vasimv/OMower/hardware/omower.schematics.png

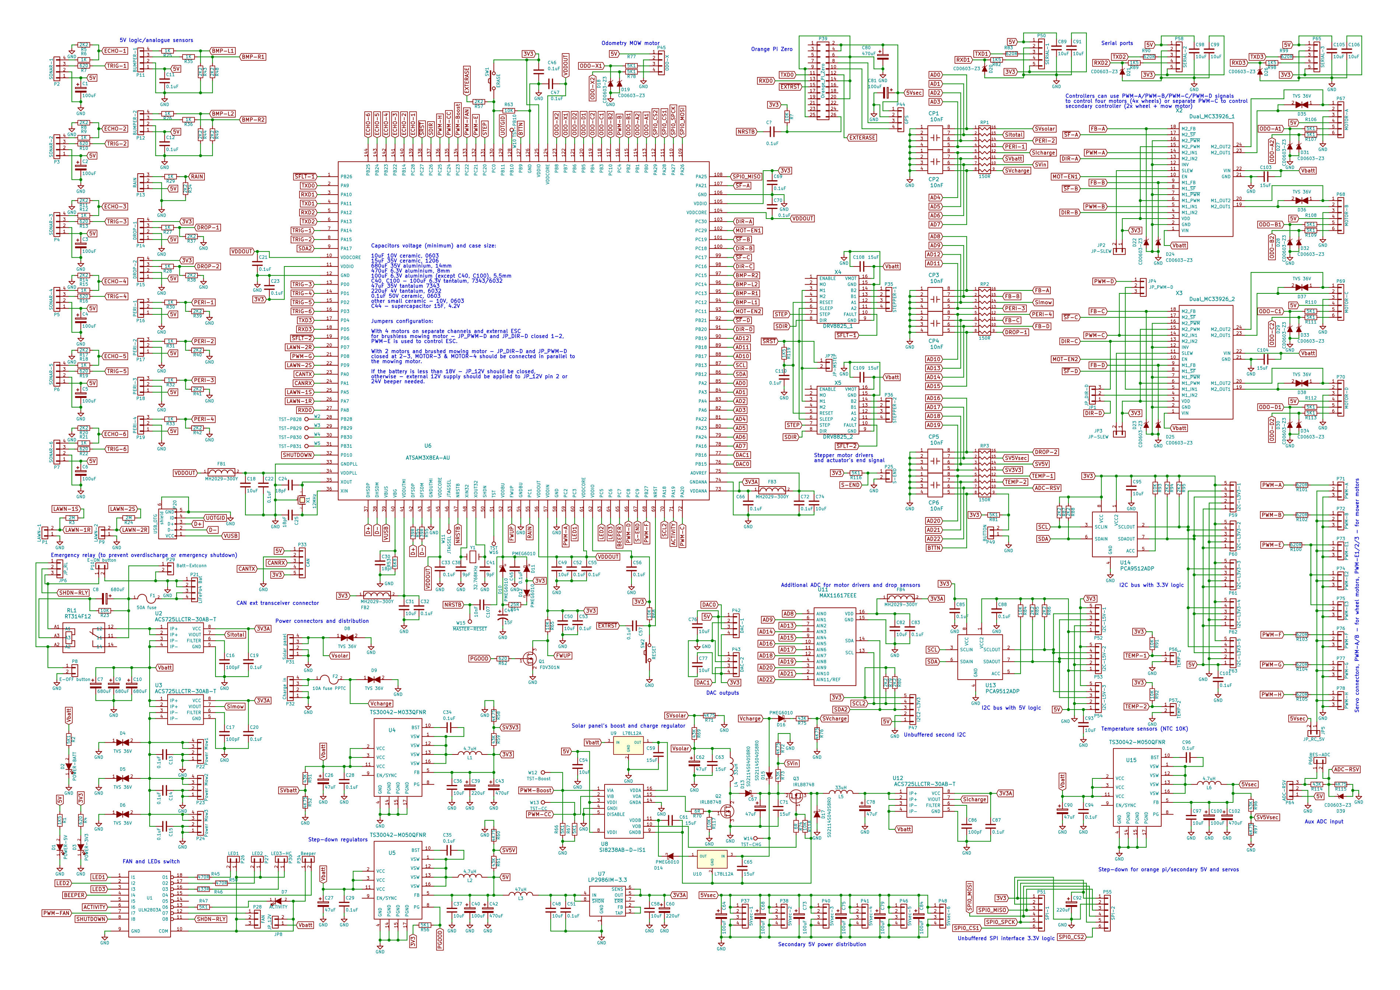
hardware/omower.schematics.png
