vasimv/OMower/(threads)

Thread 1 (2018-10-04):

bumper::init() uses incorrect PIN defs

vytautasmiel, 2018-10-04:
bumper::init():
```
// Set pins mode
  pinMode(PIN_BUMP_LEFTFORW, INPUT_PULLUP);
  pinMode(PIN_BUMP_RIGHTFORW, INPUT_PULLUP);
  pinMode(PIN_BUMP_LEFTFORW, INPUT_PULLUP);
  pinMode(PIN_BUMP_LEFTFORW, INPUT_PULLUP);
```
to be changed to:
```
// Set pins mode
  pinMode(PIN_BUMP_LEFTFORW, INPUT_PULLUP);
  pinMode(PIN_BUMP_RIGHTFORW, INPUT_PULLUP);
  pinMode(PIN_BUMP_LEFTBACK, INPUT_PULLUP);
  pinMode(PIN_BUMP_RIGHTBACK, INPUT_PULLUP);
```

vasimv, 2018-10-05:
Thank you for report, fixed in https://github.com/vasimv/OMower/commit/53f4aa3ddb05e08787ec44733da7716eb146eca8

Closed 2018-10-05.
