vasimv/OMower/hardware/OMower/omower.kicad_pcb

## KiCad design hardware/OMower/omower.kicad_pcb (2018-01-07)

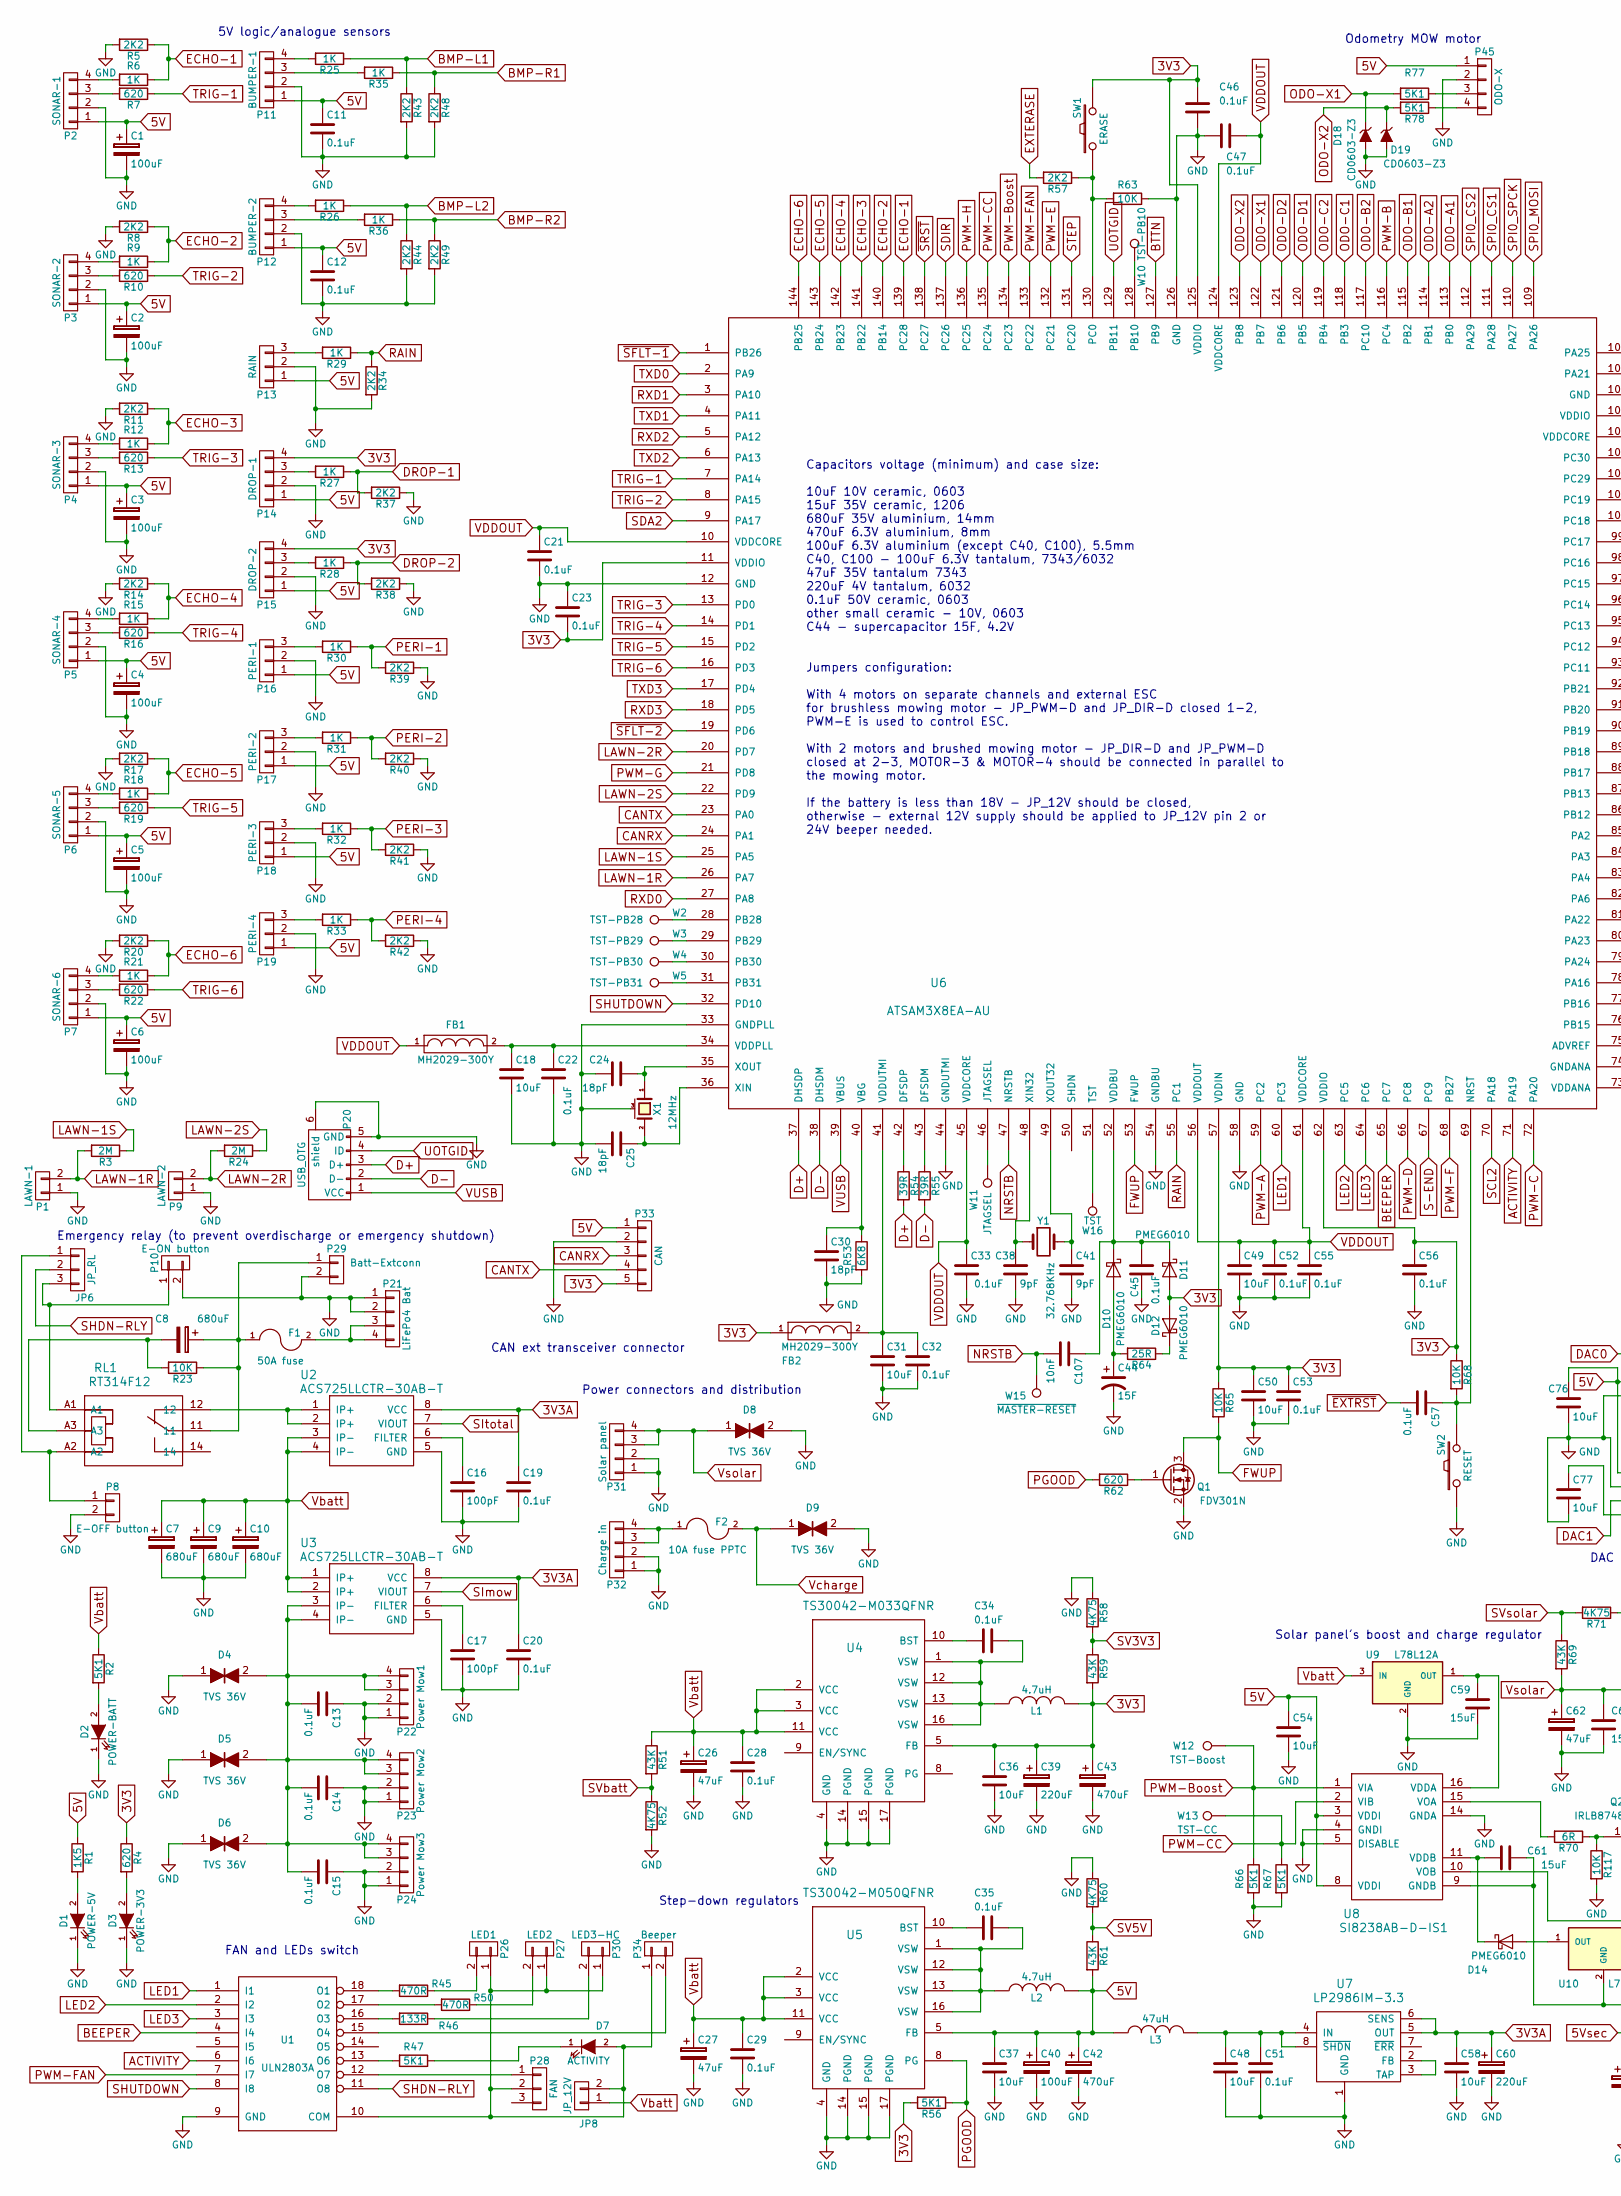
[picture p2: schematic omower.sch, part in row 1, column 1]

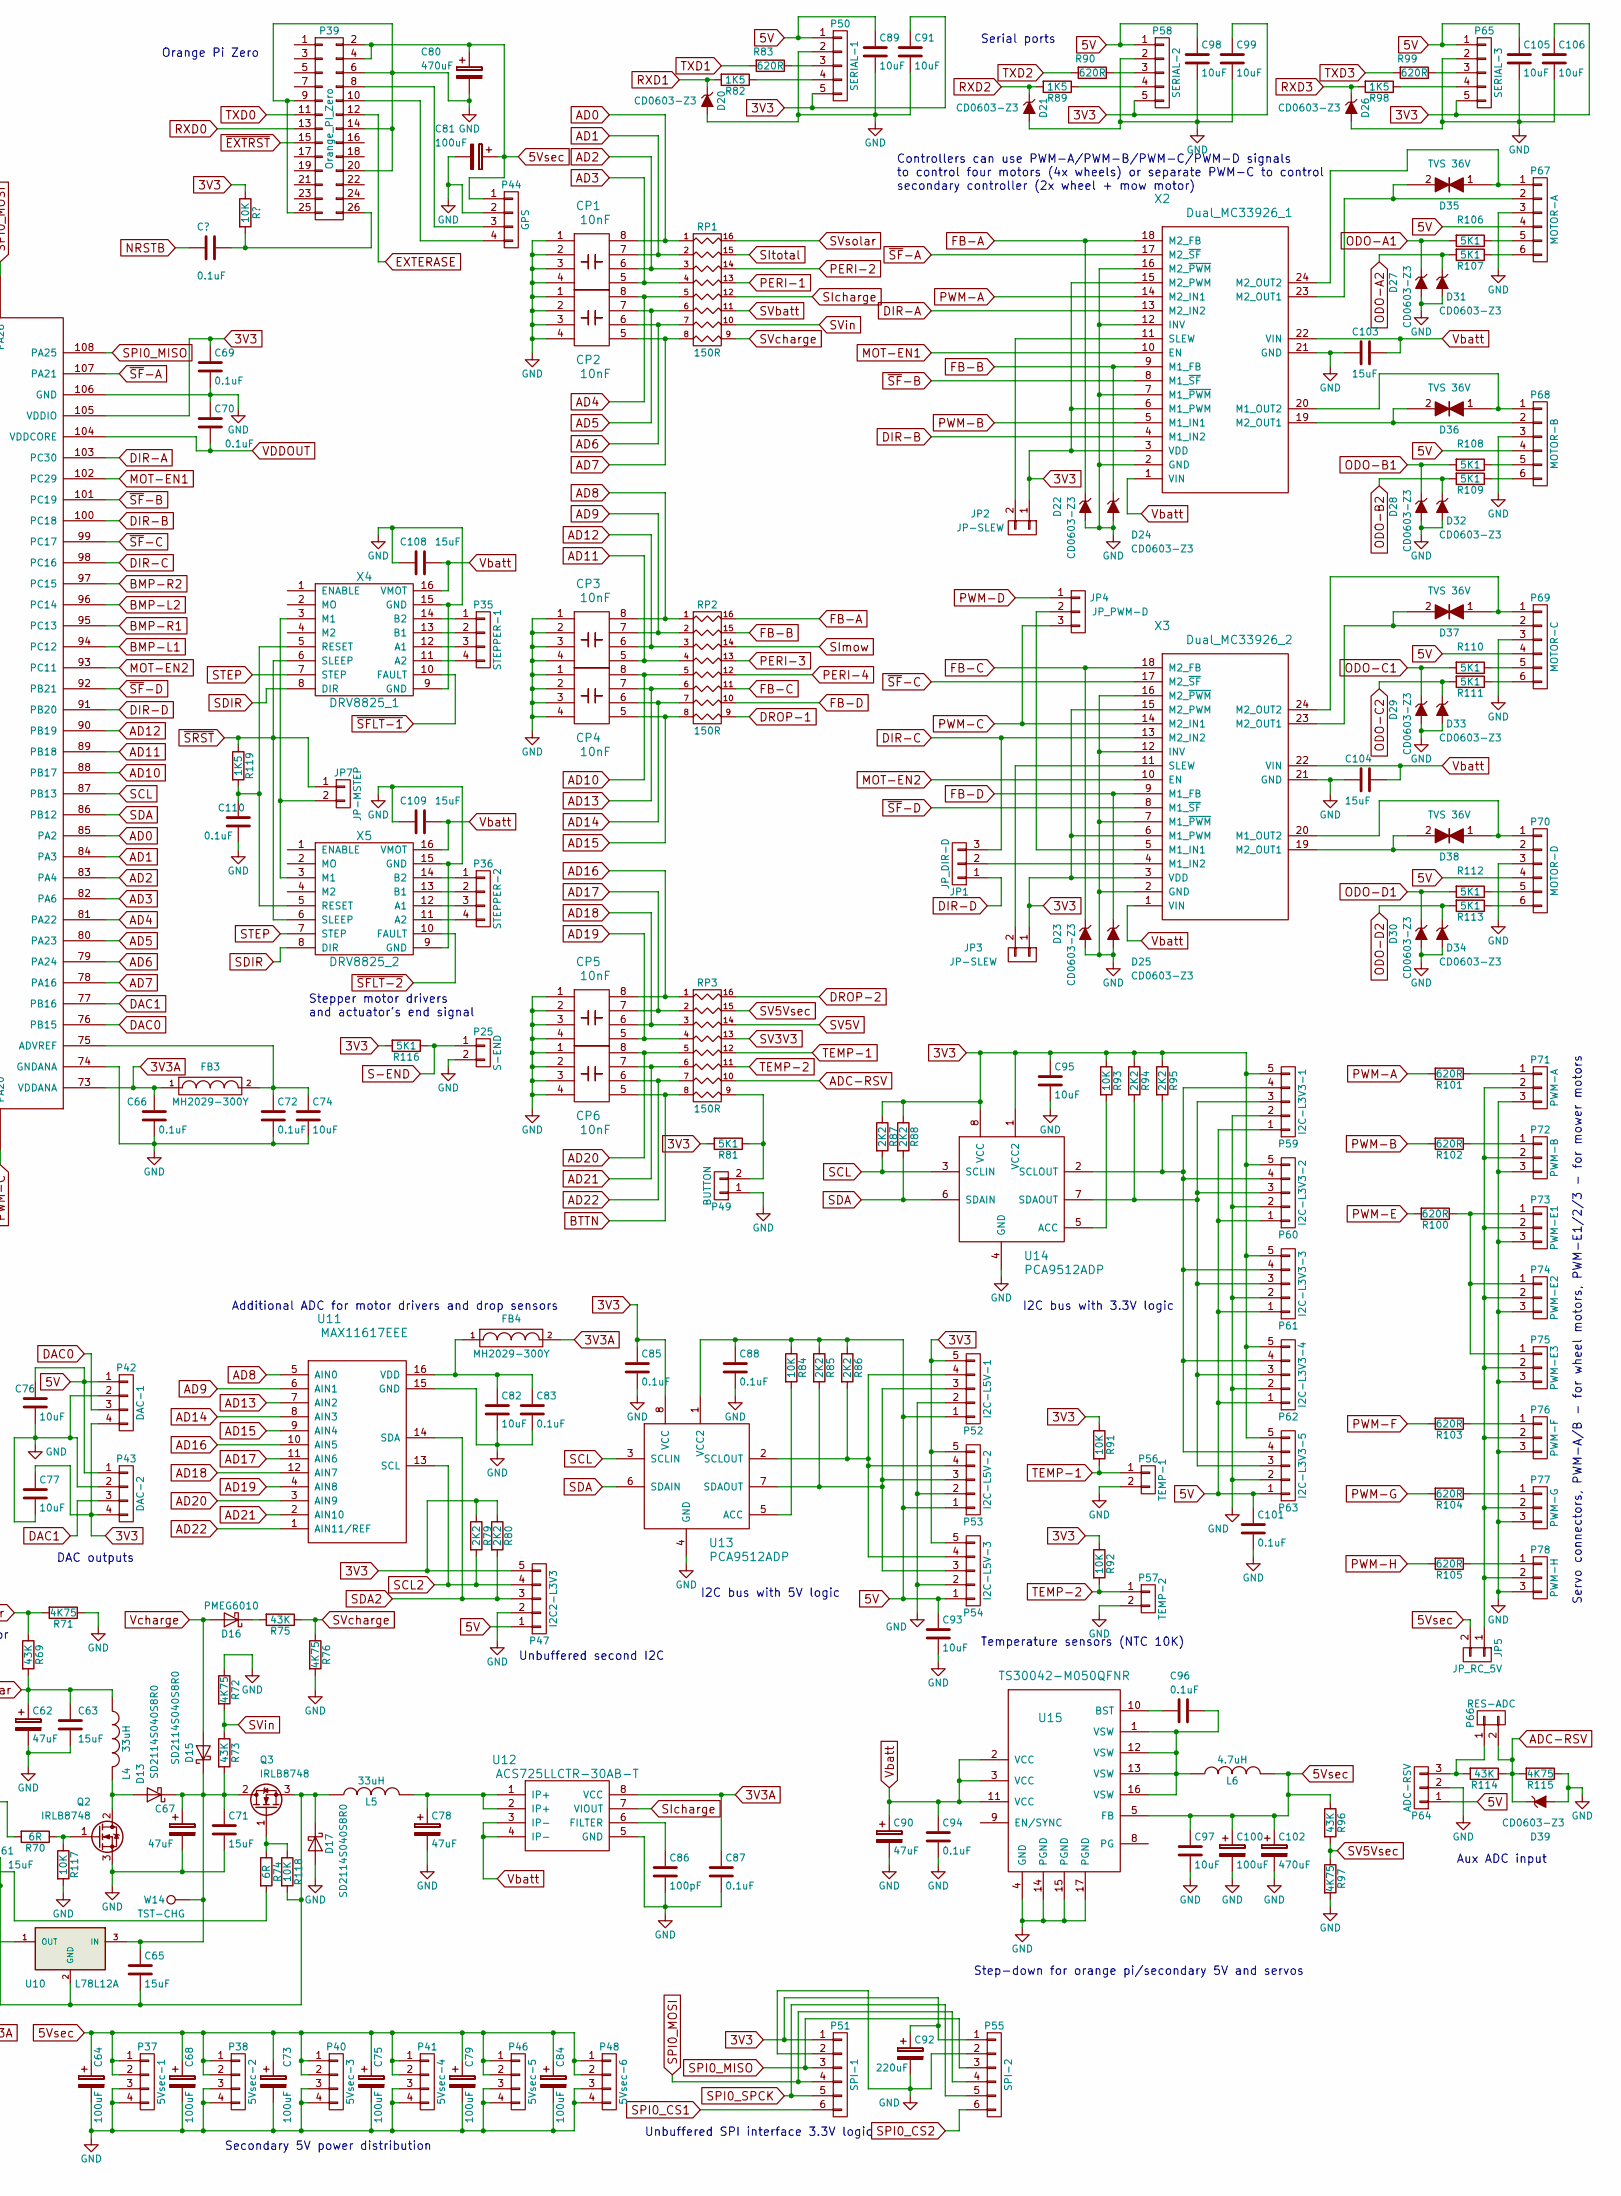
[picture p3: schematic omower.sch, part in row 1, column 2]

Parts:
C1, C2, C3, C4, C5, C6, C64, C68, C73, C75, C79, C84: 100uF; c_elec_6.3x5.7; Voltage 6.3V
C7, C8, C9, C10: 680uF; CPCASE-12.5; Voltage 35V
C11, C12, C13, C14, C15, C19, C20, C28, C29, C51, C83, C87, C94, C101, C110: 0.1uF; C_0805
C16, C17, C86: 100pF; C_0805
C18, C31, C49, C50: 10uF; C_0603; Voltage 10V
C21, C22, C23, C32, C33, C34, C35, C45, C46, C47, C52, C53, C55, C56, C57, C66, C69, C70, C72, C85, C88, C96: 0.1uF; C_0603
C24, C25, C30: 18pF; C_0805
C26, C27, C62, C67, C78: 47uF; TantalC_SizeX_EIA-7343; Voltage 35V
C36, C37, C48, C54, C58, C82, C97: 10uF; C_1206
C38, C41: 9pF; C_0805
C39, C60, C92: 220uF; TantalC_SizeC_EIA-6032_Reflow; Voltage 4V
C40, C100: 100uF; TantalC_SizeD_EIA-7343_Reflow; Voltage 6.3V
C42, C80, C102: 470uF; c_elec_8x10.5; Voltage 6.3V
C43: 470uF; c_elec_8x10.5; Voltage 4V
C44: 15F; Supercap-Vishay_E3_22_24; Voltage 4.2V
C59, C61, C63, C65, C71: 15uF; C_1206; Voltage 35V
C74, C89, C91, C98, C99, C105, C106: 10uF; C_1206; Voltage 10V
C76, C77, C95: 10uF; C_0603
C81: 100uF; TantalC_SizeD_EIA-7343_Reflow
C90: 47uF; TantalC_SizeX_EIA-7343; Voltage 10V
C93: 10uF; C_0805
C103, C104: 15uF; C_0805
C107: 10nF; C_0805
C108, C109: 15uF; C_1206
CP1, CP2, CP3, CP4, CP5, CP6: 10nF; R_Array_Concave_4x0402
D1: POWER-5V; LED-3MM
D2: POWER-BATT; LED-3MM
D3: POWER-3V3; LED-3MM
D4, D5, D6, D8, D9, D35, D36, D37, D38: TVS 36V; R_0402
D7: ACTIVITY; LED-3MM
D10, D11, D12, D14, D16: PMEG6010; SOD-123
D13, D15, D17: SD2114S040S8R0; SMB_Standard
D18, D19, D20, D21, D22, D23, D24, D25, D26, D27, D28, D29, D30, D31, D32, D33, D34, D39: CD0603-Z3; SOD-523
F1: 50A fuse; MAXI-Fuse-Clip-29.21
F2: 10A fuse PPTC; RV_Disc_D21.5_W5.3_P10
FB1, FB2, FB3, FB4: MH2029-300Y; R_0805
JP1: JP_DIR-D; Pin_Header_Straight_1x03
JP2, JP3: JP-SLEW; Pin_Header_Straight_1x02
JP4: JP_PWM-D; Pin_Header_Straight_1x03
JP5: JP_RC_5V; Pin_Header_Straight_1x02
JP6: JP_RL; Pin_Header_Straight_1x03
JP7: JP-MSTEP; Pin_Header_Straight_1x02
JP8: JP_12V; Pin_Header_Straight_1x02
L1, L2, L6: 4.7uH; Choke_SMD_Wuerth-WE-PD2-Typ-MS
L3: 47uH; Choke_SMD_7.3x7.3_H3.5
L4, L5: 33uH; Choke-PG1096
P1: LAWN-1; Pin_Header_Straight_1x02
P2: SONAR-1; Pin_Header_Straight_1x04
P3: SONAR-2; Pin_Header_Straight_1x04
P4: SONAR-3; Pin_Header_Straight_1x04
P5: SONAR-4; Pin_Header_Straight_1x04
P6: SONAR-5; Pin_Header_Straight_1x04
P7: SONAR-6; Pin_Header_Straight_1x04
P8: E-OFF button; Pin_Header_Straight_1x02
P9: LAWN-2; Pin_Header_Straight_1x02
P10: E-ON button; Pin_Header_Straight_1x02
P11: BUMPER-1; Pin_Header_Straight_1x04
P12: BUMPER-2; Pin_Header_Straight_1x04
P13: RAIN; Pin_Header_Straight_1x03
P14: DROP-1; Pin_Header_Straight_1x04
P15: DROP-2; Pin_Header_Straight_1x04
P16: PERI-1; Pin_Header_Straight_1x03
P17: PERI-2; Pin_Header_Straight_1x03
P18: PERI-3; Pin_Header_Straight_1x03
P19: PERI-4; Pin_Header_Straight_1x03
P20: USB_OTG; USB_Micro-B_10103594-0001LF
P21: LiFePo4 Bat; Molex_MiniFit-JR-5569-04A2_2x02x4.20mm_Angled
P22: Power Mow1; Molex_MiniFit-JR-5569-04A2_2x02x4.20mm_Angled
P23: Power Mow2; Molex_MiniFit-JR-5569-04A2_2x02x4.20mm_Angled
P24: Power Mow3; Molex_MiniFit-JR-5569-04A2_2x02x4.20mm_Angled
P25: S-END; Pin_Header_Straight_1x02
P26: LED1; Pin_Header_Straight_1x02
P27: LED2; Pin_Header_Straight_1x02
P28: FAN; Pin_Header_Straight_1x03
P29: Batt-Extconn; Pin_Header_Straight_1x02
P30: LED3-HC; Pin_Header_Straight_1x02
P31: Solar panel; Molex_MiniFit-JR-5569-04A2_2x02x4.20mm_Angled
P32: Charge in; Molex_MiniFit-JR-5569-04A2_2x02x4.20mm_Angled
P33: CAN; Pin_Header_Straight_1x05
P34: Beeper; Pin_Header_Straight_1x02
P35: STEPPER-1; Pin_Header_Straight_1x04
P36: STEPPER-2; Pin_Header_Straight_1x04
P37: 5Vsec-1; Pin_Header_Straight_1x04
P38: 5Vsec-2; Pin_Header_Straight_1x04
P39: Orange_PI_Zero; Pin_Header_Straight_2x13
P40: 5Vsec-3; Pin_Header_Straight_1x04
P41: 5Vsec-4; Pin_Header_Straight_1x04
P42: DAC-1; Pin_Header_Straight_1x04
P43: DAC-2; Pin_Header_Straight_1x04
P44: GPS; Pin_Header_Straight_1x04
P45: ODO-X; Pin_Header_Straight_1x04
P46: 5Vsec-5; Pin_Header_Straight_1x04
P47: I2C2-L3V3; Pin_Header_Straight_1x05
P48: 5Vsec-6; Pin_Header_Straight_1x04
P49: BUTTON; Pin_Header_Straight_1x02
P50: SERIAL-1; Pin_Header_Straight_1x05
P51: SPI-1; Pin_Header_Straight_1x06
P52: I2C-L5V-1; Pin_Header_Straight_1x05
P53: I2C-L5V-2; Pin_Header_Straight_1x05
P54: I2C-L5V-3; Pin_Header_Straight_1x05
P55: SPI-2; Pin_Header_Straight_1x06
P56: TEMP-1; Pin_Header_Straight_1x02
P57: TEMP-2; Pin_Header_Straight_1x02
P58: SERIAL-2; Pin_Header_Straight_1x05
P59: I2C-L3V3-1; Pin_Header_Straight_1x05
P60: I2C-L3V3-2; Pin_Header_Straight_1x05
P61: I2C-L3V3-3; Pin_Header_Straight_1x05
P62: I2C-L3V3-4; Pin_Header_Straight_1x05
P63: I2C-L3V3-5; Pin_Header_Straight_1x05
P64: ADC-RSV; Pin_Header_Straight_1x03
P65: SERIAL-3; Pin_Header_Straight_1x05
P66: RES-ADC; Pin_Header_Straight_1x02
P67: MOTOR-A; Pin_Header_Straight_1x06
P68: MOTOR-B; Pin_Header_Straight_1x06
P69: MOTOR-C; Pin_Header_Straight_1x06
P70: MOTOR-D; Pin_Header_Straight_1x06
P71: PWM-A; Pin_Header_Straight_1x03
P72: PWM-B; Pin_Header_Straight_1x03
P73: PWM-E1; Pin_Header_Straight_1x03
P74: PWM-E2; Pin_Header_Straight_1x03
P75: PWM-E3; Pin_Header_Straight_1x03
P76: PWM-F; Pin_Header_Straight_1x03
P77: PWM-G; Pin_Header_Straight_1x03
P78: PWM-H; Pin_Header_Straight_1x03
Q1: FDV301N; SOT-23
Q2, Q3: IRLB8748; TO-220_Neutral123_Horizontal_LargePads
R1, R82, R89, R98, R119: 1K5; R_0603
R2, R47, R56, R66, R67, R77, R78, R81, R106, R107, R108, R109, R110, R111, R112, R113, R116: 5K1; R_0603
R3, R24: 2M; R_0603
R4, R7, R10, R13, R16, R19, R22, R62: 620; R_0603
R5, R8, R11, R14, R17, R20, R34, R37, R38, R39, R40, R41, R42, R43, R44, R48, R49, R57, R79, R80, R85, R86, R87, R88, R94, R95: 2K2; R_0603
R6, R9, R12, R15, R18, R21, R25, R26, R27, R28, R29, R30, R31, R32, R33, R35, R36: 1K; R_0603
R23, R63, R65, R68, R84, R91, R92, R93, R117, R118: 10K; R_0603
R45, R50: 470R; R_0805
R46: 133R; R_0805
R51, R59, R61, R69, R73, R75, R96, R114: 43K; R_0603
R52, R58, R60, R71, R72, R76, R97, R115: 4K75; R_0603
R53: 6K8; R_0603
R54, R55: 39R; R_0603
R64: 25R; R_0603
R70, R74: 6R; R_0805
R83, R90, R99, R100, R101, R102, R103, R104, R105: 620R; R_0603
RL1: RT314F12; Relay_RT314F12
RP1, RP2, RP3: 150R; R_Array_Convex_8x0602
SW1: ERASE; SW_SPST_EVQPE1
SW2: RESET; SW_SPST_EVQPE1
U1: ULN2803A; SOIC-18_7.5x11.6mm_Pitch1.27mm
U2, U3, U12: ACS725LLCTR-30AB-T; SOIC-8-N
U4: TS30042-M033QFNR; QFN-16-1EP_3x3mm_Pitch0.5mm
U5, U15: TS30042-M050QFNR; QFN-16-1EP_3x3mm_Pitch0.5mm
U6: ATSAM3X8EA-AU; LQFP-144_20x20mm_Pitch0.5mm
U7: LP2986IM-3.3; SOIC-8-N
U8: SI8238AB-D-IS1; SOIC-16_3.9x9.9mm_Pitch1.27mm
U9, U10: L78L12A; SOT89-3_Housing
U11: MAX11617EEE; QSOP-16_3.9x4.9mm_Pitch0.635mm
U13, U14: PCA9512ADP; MSOP-8_3x3mm_Pitch0.65mm
W2: TST-PB28; Wirepad_SMD_2x2mm
W3: TST-PB29; Wirepad_SMD_2x2mm
W4: TST-PB30; Wirepad_SMD_2x2mm
W5: TST-PB31; Wirepad_SMD_2x2mm
W10: TST-PB10; Wirepad_SMD_2x2mm
W11: JTAGSEL; Wirepad_SMD_2x2mm
W12: TST-Boost; Pin_Header_Straight_1x01
W13: TST-CC; Pin_Header_Straight_1x01
W14: TST-CHG; Pin_Header_Straight_1x01
W15: ~MASTER-RESET; Pin_Header_Straight_1x01
W16: TST; Wirepad_SMD_2x2mm
X1: 12MHz; crystal_FA238-TSX3225
X2: Dual_MC33926_1; POLULU-DUAL_MC33926
X3: Dual_MC33926_2; POLULU-DUAL_MC33926
X4: DRV8825_1; POLOLU-DRV8825
X5: DRV8825_2; POLOLU-DRV8825
Y1: 32.768KHz; R_1206

Connections:
3V3: C23.2, C36.1, C39.1, C43.1, C46.1, C50.1, C53.1, C56.1, C69.1, C77.1, C85.1, C91.1, C92.1, C95.1, C99.1, C106.1, D11.2 (A), D12.2 (A), FB2.1, JP2.1, JP3.1, L1.2, P14.4, P15.4, P33.5, P42.4, P43.4, P47.5, P50.5, P51.1, P52.5, P53.5, P54.5, P55.1, P58.5, P59.5, P60.5, P61.5, P62.5, P63.5, P65.5, R4.1, R56.2, R59.2, R65.1, R68.1, R79.1, R80.1, R81.2, R87.1, R88.1, R91.1, R92.1, R93.1, R94.1, R95.1, R116.2, SW1.2, U4.5 (FB), U6.11 (VDDIO), U6.57 (VDDIN), U6.62 (VDDIO), U6.105 (VDDIO), U6.125 (VDDIO), U13.8 (VCC), U14.1 (VCC2), U14.8 (VCC), X2.3 (VDD), X2.6 (M1_PWM), X2.15 (M2_PWM), X3.3 (VDD), X3.6 (M1_PWM), X3.15 (M2_PWM)
3V3A: C19.1, C20.1, C58.1, C60.1, C66.1, C87.1, FB3.1, FB4.2, U2.8 (VCC), U3.8 (VCC), U6.73 (VDDANA), U7.5 (OUT), U7.6 (SENS), U12.8 (VCC)
5V: C1.1, C2.1, C3.1, C4.1, C5.1, C6.1, C11.1, C12.1, C37.1, C40.1, C42.1, C54.1, C76.1, C88.1, C89.1, C93.1, C98.1, C101.1, C105.1, L2.2, L3.1, P2.1, P3.1, P4.1, P5.1, P6.1, P7.1, P11.1, P12.1, P13.1, P14.1, P15.1, P16.1, P17.1, P18.1, P19.1, P33.1, P42.1, P43.1, P45.1, P47.1, P50.1, P52.1, P53.1, P54.1, P58.1, P59.1, P60.1, P61.1, P62.1, P63.1, P64.1, P65.1, P67.4, P68.4, P69.4, P70.4, R1.1, R61.2, R84.1, R85.1, R86.1, U5.5 (FB), U8.3 (VDDI), U8.8 (VDDI), U13.1 (VCC2)
5Vsec: C64.1, C68.1, C73.1, C75.1, C79.1, C80.1, C81.1, C84.1, C97.1, C100.1, C102.1, JP5.2, L6.2, P37.1, P37.2, P38.1, P38.2, P39.2, P39.4, P40.1, P40.2, P41.1, P41.2, P44.1, P46.1, P46.2, P48.1, P48.2, R96.1, U15.5 (FB)
ACTIVITY: U1.6 (I6), U6.71 (PA19)
AD0: CP1.8, RP1.1, U6.85 (PA2)
AD1: CP1.7, RP1.2, U6.84 (PA3)
AD2: CP1.6, RP1.3, U6.83 (PA4)
AD3: CP1.5, RP1.4, U6.82 (PA6)
AD4: CP2.8, RP1.5, U6.81 (PA22)
AD5: CP2.7, RP1.6, U6.80 (PA23)
AD6: CP2.6, RP1.7, U6.79 (PA24)
AD7: CP2.5, RP1.8, U6.78 (PA16)
AD8: CP3.8, RP2.1, U11.5 (AIN0)
AD9: CP3.7, RP2.2, U11.6 (AIN1)
AD10: CP4.8, RP2.5, U6.88 (PB17)
AD11: CP3.5, RP2.4, U6.89 (PB18)
AD12: CP3.6, RP2.3, U6.90 (PB19)
AD13: CP4.7, RP2.6, U11.7 (AIN2)
AD14: CP4.6, RP2.7, U11.8 (AIN3)
AD15: CP4.5, RP2.8, U11.9 (AIN4)
AD16: CP5.8, RP3.1, U11.10 (AIN5)
AD17: CP5.7, RP3.2, U11.11 (AIN6)
AD18: CP5.6, RP3.3, U11.12 (AIN7)
AD19: CP5.5, RP3.4, U11.4 (AIN8)
AD20: CP6.8, RP3.5, U11.3 (AIN9)
AD21: CP6.7, RP3.6, U11.2 (AIN10)
AD22: CP6.6, RP3.7, U11.1 (AIN11/REF)
ADC-RSV: D39.1 (K), P66.2, R114.1, R115.2, RP3.10 (R7)
BEEPER: U1.4 (I4), U6.65 (PC7)
BMP-L1: R25.1, R43.1, U6.94 (PC12)
BMP-L2: R26.1, R44.1, U6.96 (PC14)
BMP-R1: R35.1, R48.1, U6.95 (PC13)
BMP-R2: R36.1, R49.1, U6.97 (PC15)
BTTN: CP6.5, RP3.8, U6.127 (PB9)
CANRX: P33.3, U6.24 (PA1)
CANTX: P33.4, U6.23 (PA0)
D+: P20.3 (D+), R54.2, U6.37 (DHSDP)
D-: P20.2 (D-), R55.2, U6.38 (DHSDM)
DAC0: P42.3, U6.76 (PB15)
DAC1: P43.3, U6.77 (PB16)
DIR-A: U6.103 (PC30), X2.13 (M2_IN2)
DIR-B: U6.100 (PC18), X2.4 (M1_IN2)
DIR-C: JP1.3, U6.98 (PC16), X3.13 (M2_IN2)
DIR-D: JP1.1, U6.91 (PB20)
DROP-1: R27.1, R37.2, RP2.9 (R8)
DROP-2: R28.1, R38.2, RP3.16 (R1)
ECHO-1: R5.1, R6.1, U6.139 (PC28)
ECHO-2: R8.1, R9.1, U6.140 (PB14)
ECHO-3: R11.1, R12.1, U6.141 (PB22)
ECHO-4: R14.1, R15.1, U6.142 (PB23)
ECHO-5: R17.1, R18.1, U6.143 (PB24)
ECHO-6: R20.1, R21.1, U6.144 (PB25)
EXTERASE: P39.12, R57.2
FB-A: D22.1 (K), RP2.16 (R1), X2.18 (M2_FB)
FB-B: D24.1 (K), RP2.15 (R2), X2.9 (M1_FB)
FB-C: D23.1 (K), RP2.11 (R6), X3.18 (M2_FB)
FB-D: D25.1 (K), RP2.10 (R7), X3.9 (M1_FB)
FWUP: Q1.3 (D), R65.2, U6.53 (FWUP)
GND: C1.2, C2.2, C3.2, C4.2, C5.2, C6.2, C7.2, C9.2, C10.2, C11.2, C12.2, C13.1, C14.1, C15.1, C16.2, C17.2, C18.2, C19.2, C20.2, C21.2, C22.2, C23.1, C24.2, C25.2, C26.2, C27.2, C28.2, C29.2, C30.2, C31.2, C32.2, C33.2, C36.2, C37.2, C38.2, C39.2, C40.2, C41.2, C42.2, C43.2, C44.2, C45.2, C46.2, C47.2, C48.2, C49.2, C50.2, C51.2, C52.2, C53.2, C54.2, C55.2, C56.2, C58.2, C59.2, C60.2, C62.2, C63.2, C64.2, C66.2, C67.2, C68.2, C69.2, C70.1, C71.2, C72.2, C73.2, C74.2, C75.2, C76.2, C77.2, C78.2, C79.2, C80.2, C81.2, C82.2, C83.2, C84.2, C85.2, C86.2, C87.2, C88.2, C89.2, C90.2, C91.2, C92.2, C93.2, C94.2, C95.2, C97.2, C98.2, C99.2, C100.2, C101.2, C102.2, C103.2, C104.2, C105.2, C106.2, C108.2, C109.2, C110.2, CP1.1, CP1.2, CP1.3, CP1.4, CP2.1, CP2.2, CP2.3, CP2.4, CP3.1, CP3.2, CP3.3, CP3.4, CP4.1, CP4.2, CP4.3, CP4.4, CP5.1, CP5.2, CP5.3, CP5.4, CP6.1, CP6.2, CP6.3, CP6.4, D1.1 (K), D2.1 (K), D3.1 (K), D4.1, D5.1, D6.1, D8.2, D9.2, D17.2 (A), D18.2 (A), D19.2 (A), D20.2 (A), D21.2 (A), D22.2 (A), D23.2 (A), D24.2 (A), D25.2 (A), D26.2 (A), D27.2 (A), D28.2 (A), D29.2 (A), D30.2 (A), D31.2 (A), D32.2 (A), D33.2 (A), D34.2 (A), D39.2 (A), P1.1, P2.2, P3.2, P4.2, P5.2, P6.2, P7.2, P8.2, P9.1, P10.2, P11.2, P12.2, P13.2, P14.2, P15.2, P16.2, P17.2, P18.2, P19.2, P20.5 (GND), P20.6 (shield), P21.1, P21.2, P22.1, P22.2, P23.1, P23.2, P24.1, P24.2, P25.2, P29.2, P31.1, P31.2, P32.1, P32.2, P33.2, P37.3, P37.4, P38.3, P38.4, P39.6, P39.9, P39.14, P39.20, P39.25, P40.3, P40.4, P41.3, P41.4, P42.2, P43.2, P44.2, P45.2, P46.3, P46.4, P47.2, P48.3, P48.4, P49.1, P50.2, P51.2, P52.2, P53.2, P54.2, P55.2, P56.2, P57.2, P58.2, P59.2, P60.2, P61.2, P62.2, P63.2, P64.2, P65.2, P67.3, P68.3, P69.3, P70.3, P71.3, P72.3, P73.3, P74.3, P75.3, P76.3, P77.3, P78.3, Q1.2 (S), Q2.3 (S), R5.2, R8.2, R11.2, R14.2, R17.2, R20.2, R34.2, R37.1, R38.1, R39.1, R40.1, R41.1, R42.1, R43.2, R44.2, R48.2, R49.2, R52.2, R53.2, R58.1, R60.1, R63.1, R66.2, R67.2, R71.1, R72.1, R76.2, R97.2, R115.1, R117.2, SW2.1, U1.9 (GND), U2.5 (GND), U3.5 (GND), U4.4 (GND), U4.14 (PGND), U4.15 (PGND), U4.17 (PGND), U5.4 (GND), U5.14 (PGND), U5.15 (PGND), U5.17 (PGND), U6.12 (GND), U6.33 (GNDPLL), U6.44 (GNDUTMI), U6.54 (GNDBU), U6.58 (GND), U6.74 (GNDANA), U6.106 (GND), U6.126 (GND), U7.1 (GND), U8.4 (GNDI), U8.5 (DISABLE), U8.14 (GNDA), U9.2 (GND), U11.15 (GND), U12.5 (GND), U13.4 (GND), U14.4 (GND), U15.4 (GND), U15.14 (PGND), U15.15 (PGND), U15.17 (PGND), X1.3 (case), X2.2 (GND), X2.7 (M1_~PWM), X2.12 (INV), X2.16 (M2_~PWM), X2.21 (GND), X3.2 (GND), X3.7 (M1_~PWM), X3.12 (INV), X3.16 (M2_~PWM), X3.21 (GND), X4.9 (GND), X4.15 (GND), X5.9 (GND), X5.15 (GND)
LAWN-1R: P1.2, R3.2, U6.26 (PA7)
LAWN-1S: R3.1, U6.25 (PA5)
LAWN-2R: P9.2, R24.2, U6.20 (PD7)
LAWN-2S: R24.1, U6.22 (PD9)
LED1: U1.1 (I1), U6.60 (PC3)
LED2: U1.2 (I2), U6.63 (PC5)
LED3: U1.3 (I3), U6.64 (PC6)
MOT-EN1: U6.102 (PC29), X2.10 (EN)
MOT-EN2: U6.93 (PC11), X3.10 (EN)
NRSTB: C107.2, U6.47 (NRSTB), W15.1
unnamed: C8.1, F1.1, P29.1, R23.1, RL1.11
unnamed: C13.2, C14.2, C15.2, D4.2, D5.2, D6.2, P22.3, P22.4, P23.3, P23.4, P24.3, P24.4, U3.3 (IP-), U3.4 (IP-)
unnamed: C16.1, U2.6 (FILTER)
unnamed: C17.1, U3.6 (FILTER)
unnamed: C18.1, C22.1, FB1.2, U6.34 (VDDPLL)
unnamed: C24.1, U6.35 (XOUT), X1.1
unnamed: C25.1, U6.36 (XIN), X1.2
unnamed: C30.1, R53.1, U6.40 (VBG)
unnamed: C31.1, C32.1, FB2.2, U6.41 (VDDUTMI)
unnamed: C34.1, L1.1, U4.1 (VSW), U4.12 (VSW), U4.13 (VSW), U4.16 (VSW)
unnamed: C34.2, U4.10 (BST)
unnamed: C35.1, L2.1, U5.1 (VSW), U5.12 (VSW), U5.13 (VSW), U5.16 (VSW)
unnamed: C35.2, U5.10 (BST)
unnamed: C38.1, U6.48 (XIN32), Y1.1
unnamed: C41.1, U6.49 (XOUT32), Y1.2
unnamed: C44.1, D10.2 (A), R64.2
unnamed: C48.1, C51.1, L3.2, U7.4 (IN), U7.8 (~SHDN)
unnamed: C57.1, R68.2, SW2.2, U6.69 (NRST)
unnamed: C59.1, U8.16 (VDDA), U9.1 (OUT)
unnamed: C61.1, C65.2, D17.1 (K), L5.1, Q3.3 (S), R118.2, U8.9 (GNDB), U10.2 (GND)
unnamed: C72.1, C74.1, FB3.2, U6.75 (ADVREF)
unnamed: C78.1, L5.2, U12.1 (IP+), U12.2 (IP+)
unnamed: C82.1, C83.1, FB4.1, U11.16 (VDD)
unnamed: C86.1, U12.6 (FILTER)
unnamed: C96.1, L6.1, U15.1 (VSW), U15.12 (VSW), U15.13 (VSW), U15.16 (VSW)
unnamed: C96.2, U15.10 (BST)
unnamed: C45.1, C107.1, D10.1 (K), D11.1 (K), U6.52 (VDDBU)
unnamed: C110.1, R119.2, X4.5 (RESET), X5.5 (RESET)
unnamed: D1.2 (A), R1.2
unnamed: D2.2 (A), R2.2
unnamed: D3.2 (A), R4.2
unnamed: D7.1 (K), R47.1
unnamed: D7.2 (A), JP8.2, P26.1, P27.1, P28.2, P30.1, P34.1, U1.10 (COM)
unnamed: D12.1 (K), R64.1
unnamed: D13.2 (A), L4.2, Q2.2 (D)
unnamed: D16.1 (K), R75.2
unnamed: D35.1, P67.1, X2.24 (M2_OUT2)
unnamed: D35.2, P67.2, X2.23 (M2_OUT1)
unnamed: D36.1, P68.1, X2.20 (M1_OUT2)
unnamed: D36.2, P68.2, X2.19 (M2_OUT1)
unnamed: D37.1, P69.1, X3.24 (M2_OUT2)
unnamed: D37.2, P69.2, X3.23 (M2_OUT1)
unnamed: D38.1, P70.1, X3.20 (M1_OUT2)
unnamed: D38.2, P70.2, X3.19 (M2_OUT1)
unnamed: F1.2, P21.3, P21.4
unnamed: F2.1, P32.3, P32.4
unnamed: JP1.2, X3.4 (M1_IN2)
unnamed: JP2.2, X2.11 (SLEW)
unnamed: JP3.2, X3.11 (SLEW)
unnamed: JP4.2, X3.5 (M1_IN1)
unnamed: JP5.1, P71.2, P72.2, P73.2, P74.2, P75.2, P76.2, P77.2, P78.2
unnamed: JP6.3, P10.1, RL1.A1
unnamed: JP7.2, X4.3 (M1), X5.3 (M1)
unnamed: P2.3, R7.2
unnamed: P2.4, R6.2
unnamed: P3.3, R10.2
unnamed: P3.4, R9.2
unnamed: P4.3, R13.2
unnamed: P4.4, R12.2
unnamed: P5.3, R16.2
unnamed: P5.4, R15.2
unnamed: P6.3, R19.2
unnamed: P6.4, R18.2
unnamed: P7.3, R22.2
unnamed: P7.4, R21.2
unnamed: P11.3, R35.2
unnamed: P11.4, R25.2
unnamed: P12.3, R36.2
unnamed: P12.4, R26.2
unnamed: P13.3, R29.2
unnamed: P14.3, R27.2
unnamed: P15.3, R28.2
unnamed: P16.3, R30.2
unnamed: P17.3, R31.2
unnamed: P18.3, R32.2
unnamed: P19.3, R33.2
unnamed: P26.2, R45.1
unnamed: P27.2, R50.1
unnamed: P28.1, U1.12 (O7)
unnamed: P30.2, R46.1
unnamed: P34.2, U1.15 (O4)
unnamed: P35.1, X4.14 (B2)
unnamed: P35.2, X4.13 (B1)
unnamed: P35.3, X4.12 (A1)
unnamed: P35.4, X4.11 (A2)
unnamed: P36.1, X5.14 (B2)
unnamed: P36.2, X5.13 (B1)
unnamed: P36.3, X5.12 (A1)
unnamed: P36.4, X5.11 (A2)
unnamed: P39.8, P44.3
unnamed: P39.10, P44.4
unnamed: P45.3, R77.1
unnamed: P45.4, R78.1
unnamed: P49.2, R81.1, RP3.9 (R8)
unnamed: P50.3, R83.1
unnamed: P50.4, R82.1
unnamed: P52.3, P53.3, P54.3, R85.2, U13.7 (SDAOUT)
unnamed: P52.4, P53.4, P54.4, R86.2, U13.2 (SCLOUT)
unnamed: P58.3, R90.1
unnamed: P58.4, R89.1
unnamed: P59.3, P60.3, P61.3, P62.3, P63.3, R94.2, U14.7 (SDAOUT)
unnamed: P59.4, P60.4, P61.4, P62.4, P63.4, R95.2, U14.2 (SCLOUT)
unnamed: P64.3, P66.1, R114.2
unnamed: P65.3, R99.1
unnamed: P65.4, R98.1
unnamed: P67.5, R106.1
unnamed: P67.6, R107.1
unnamed: P68.5, R108.1
unnamed: P68.6, R109.1
unnamed: P69.5, R110.1
unnamed: P69.6, R111.1
unnamed: P70.5, R112.1
unnamed: P70.6, R113.1
unnamed: P71.1, R101.1
unnamed: P72.1, R102.1
unnamed: P73.1, P74.1, P75.1, R100.1
unnamed: P76.1, R103.1
unnamed: P77.1, R104.1
unnamed: P78.1, R105.1
unnamed: Q1.1 (G), R62.1
unnamed: Q2.1 (G), R70.1, R117.1
unnamed: Q3.1 (G), R74.1, R118.1
unnamed: R45.2, U1.18 (O1)
unnamed: R46.2, U1.16 (O3)
unnamed: R47.2, U1.13 (O6)
unnamed: R50.2, U1.17 (O2)
unnamed: R54.1, U6.42 (DFSDP)
unnamed: R55.1, U6.43 (DFSDM)
unnamed: R57.1, R63.2, SW1.1, U6.130 (PC0)
unnamed: R70.2, U8.15 (VOA)
unnamed: R74.2, U8.10 (VOB)
unnamed: R84.2, U13.5 (ACC)
unnamed: R93.2, U14.5 (ACC)
unnamed: RL1.12, U2.1 (IP+), U2.2 (IP+)
unnamed: U6.28 (PB28), W2.1
unnamed: U6.29 (PB29), W3.1
unnamed: U6.30 (PB30), W4.1
unnamed: U6.31 (PB31), W5.1
unnamed: U6.46 (JTAGSEL), W11.1
unnamed: U6.51 (TST), W16.1
unnamed: U6.128 (PB10), W10.1
unnamed: U7.2 (FB), U7.3 (TAP)
ODO-A1: D27.1 (K), R106.2, U6.113 (PB0)
ODO-A2: D31.1 (K), R107.2, U6.114 (PB1)
ODO-B1: D28.1 (K), R108.2, U6.115 (PB2)
ODO-B2: D32.1 (K), R109.2, U6.117 (PC10)
ODO-C1: D29.1 (K), R110.2, U6.118 (PB3)
ODO-C2: D33.1 (K), R111.2, U6.119 (PB4)
ODO-D1: D30.1 (K), R112.2, U6.120 (PB5)
ODO-D2: D34.1 (K), R113.2, U6.121 (PB6)
ODO-X1: D18.1 (K), R77.2, U6.122 (PB7)
ODO-X2: D19.1 (K), R78.2, U6.123 (PB8)
PERI-1: R30.1, R39.2, RP1.13 (R4)
PERI-2: R31.1, R40.2, RP1.14 (R3)
PERI-3: R32.1, R41.2, RP2.13 (R4)
PERI-4: R33.1, R42.2, RP2.12 (R5)
PGOOD: R56.1, R62.2, U5.8 (PG)
PWM-A: R101.2, U6.59 (PC2), X2.14 (M2_IN1)
PWM-B: R102.2, U6.116 (PC4), X2.5 (M1_IN1)
PWM-Boost: R66.1, U6.134 (PC23), U8.1 (VIA), W12.1
PWM-C: JP4.3, U6.72 (PA20), X3.14 (M2_IN1)
PWM-CC: R67.1, U6.135 (PC24), U8.2 (VIB), W13.1
PWM-D: JP4.1, U6.66 (PC8)
PWM-E: R100.2, U6.132 (PC21)
PWM-F: R103.2, U6.68 (PB27)
PWM-FAN: U1.7 (I7), U6.133 (PC22)
PWM-G: R104.2, U6.21 (PD8)
PWM-H: R105.2, U6.136 (PC25)
RAIN: R29.1, R34.1, U6.55 (PC1)
RXD0: P39.13, U6.27 (PA8)
RXD1: D20.1 (K), R82.2, U6.3 (PA10)
RXD2: D21.1 (K), R89.2, U6.5 (PA12)
RXD3: D26.1 (K), R98.2, U6.18 (PD5)
S-END: P25.1, R116.1, U6.67 (PC9)
SCL: R87.2, U6.87 (PB13), U13.3 (SCLIN), U14.3 (SCLIN)
SCL2: P47.4, R79.2, U6.70 (PA18), U11.13 (SCL)
SDA: R88.2, U6.86 (PB12), U13.6 (SDAIN), U14.6 (SDAIN)
SDA2: P47.3, R80.2, U6.9 (PA17), U11.14 (SDA)
SDIR: U6.137 (PC26), X4.8 (DIR), X5.8 (DIR)
SHDN-RLY: JP6.2, U1.11 (O8)
SHUTDOWN: U1.8 (I8), U6.32 (PD10)
SIcharge: RP1.12 (R5), U12.7 (VIOUT)
SImow: RP2.14 (R3), U3.7 (VIOUT)
SItotal: RP1.15 (R2), U2.7 (VIOUT)
SPI0_CS1: P51.6, U6.111 (PA28)
SPI0_CS2: P55.6, U6.112 (PA29)
SPI0_MISO: P51.3, P55.3, U6.108 (PA25)
SPI0_MOSI: P51.4, P55.4, U6.109 (PA26)
SPI0_SPCK: P51.5, P55.5, U6.110 (PA27)
STEP: U6.131 (PC20), X4.7 (STEP), X5.7 (STEP)
SV3V3: R58.2, R59.1, RP3.13 (R4)
SV5V: R60.2, R61.1, RP3.14 (R3)
SV5Vsec: R96.2, R97.1, RP3.15 (R2)
SVbatt: R51.2, R52.1, RP1.11 (R6)
SVcharge: R75.1, R76.1, RP1.9 (R8)
SVin: R72.2, R73.1, RP1.10 (R7)
SVsolar: R69.1, R71.2, RP1.16 (R1)
TEMP-1: P56.1, R91.2, RP3.12 (R5)
TEMP-2: P57.1, R92.2, RP3.11 (R6)
TRIG-1: R7.1, U6.7 (PA14)
TRIG-2: R10.1, U6.8 (PA15)
TRIG-3: R13.1, U6.13 (PD0)
TRIG-4: R16.1, U6.14 (PD1)
TRIG-5: R19.1, U6.15 (PD2)
TRIG-6: R22.1, U6.16 (PD3)
TXD0: P39.11, U6.2 (PA9)
TXD1: R83.2, U6.4 (PA11)
TXD2: R90.2, U6.6 (PA13)
TXD3: R99.2, U6.17 (PD4)
UOTGID: P20.4 (ID), U6.129 (PB11)
VDDOUT: C21.1, C33.1, C47.1, C49.1, C52.1, C55.1, C70.2, FB1.1, U6.10 (VDDCORE), U6.45 (VDDCORE), U6.56 (VDDOUT), U6.61 (VDDCORE), U6.104 (VDDCORE), U6.124 (VDDCORE)
VUSB: P20.1 (VCC), U6.39 (VBUS)
Vbatt: C7.1, C9.1, C10.1, C26.1, C27.1, C28.1, C29.1, C90.1, C94.1, C103.1, C104.1, C108.1, C109.1, JP8.1, R2.1, R51.1, U2.3 (IP-), U2.4 (IP-), U3.1 (IP+), U3.2 (IP+), U4.2 (VCC), U4.3 (VCC), U4.11 (VCC), U5.2 (VCC), U5.3 (VCC), U5.11 (VCC), U9.3 (IN), U12.3 (IP-), U12.4 (IP-), U15.2 (VCC), U15.3 (VCC), U15.11 (VCC), X2.1 (VIN), X2.22 (VIN), X3.1 (VIN), X3.22 (VIN), X4.16 (VMOT), X5.16 (VMOT)
Vcharge: D9.1, D15.2 (A), D16.2 (A), F2.2
Vsolar: C62.1, C63.1, D8.1, L4.1, P31.3, P31.4, R69.2
~EXTRST: C57.2, P39.15
~SFLT-1: U6.1 (PB26), X4.10 (FAULT)
~SFLT-2: U6.19 (PD6), X5.10 (FAULT)
~SF~-A: U6.107 (PA21), X2.17 (M2_~SF)
~SF~-B: U6.101 (PC19), X2.8 (M1_~SF)
~SF~-C: U6.99 (PC17), X3.17 (M2_~SF)
~SF~-D: U6.92 (PB21), X3.8 (M1_~SF)
~SRST: JP7.1, R119.1, U6.138 (PC27), X4.6 (SLEEP), X5.6 (SLEEP)

Notes on the sheet:
Power connectors and distribution
Step-down regulators
Solar panel's boost and charge regulator
Step-down for orange pi/secondary 5V and servos
Controllers can use PWM-A/PWM-B/PWM-C/PWM-D signals to control four motors (4x wheels) or separate PWM-C to control secondary controller (2x wheel + mow motor)
Servo connectors, PWM-A/B - for wheel motors, PWM-E1/2/3 - for mower motors
I2C bus with 5V logic
I2C bus with 3.3V logic
Emergency relay (to prevent overdischarge or emergency shutdown)
Unbuffered second I2C
Additional ADC for motor drivers and drop sensors
5V logic/analogue sensors
Aux ADC input
Temperature sensors (NTC 10K)
Secondary 5V power distribution
FAN and LEDs switch
Serial ports
Orange Pi Zero
Unbuffered SPI interface 3.3V logic
DAC outputs
CAN ext transceiver connector
Odometry MOW motor
Stepper motor drivers and actuator's end signal
Capacitors voltage (minimum) and case size: 10uF 10V ceramic, 0603 15uF 35V ceramic, 1206 680uF 35V aluminium, 14mm 470uF 6.3V aluminium, 8mm 100uF 6.3V aluminium (except C40, C100), 5.5mm C40, C100 - 100uF 6.3V tantalum, 7343/6032 47uF 35V tantalum 7343 220uF 4V tantalum, 6032 0.1uF 50V ceramic, 0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
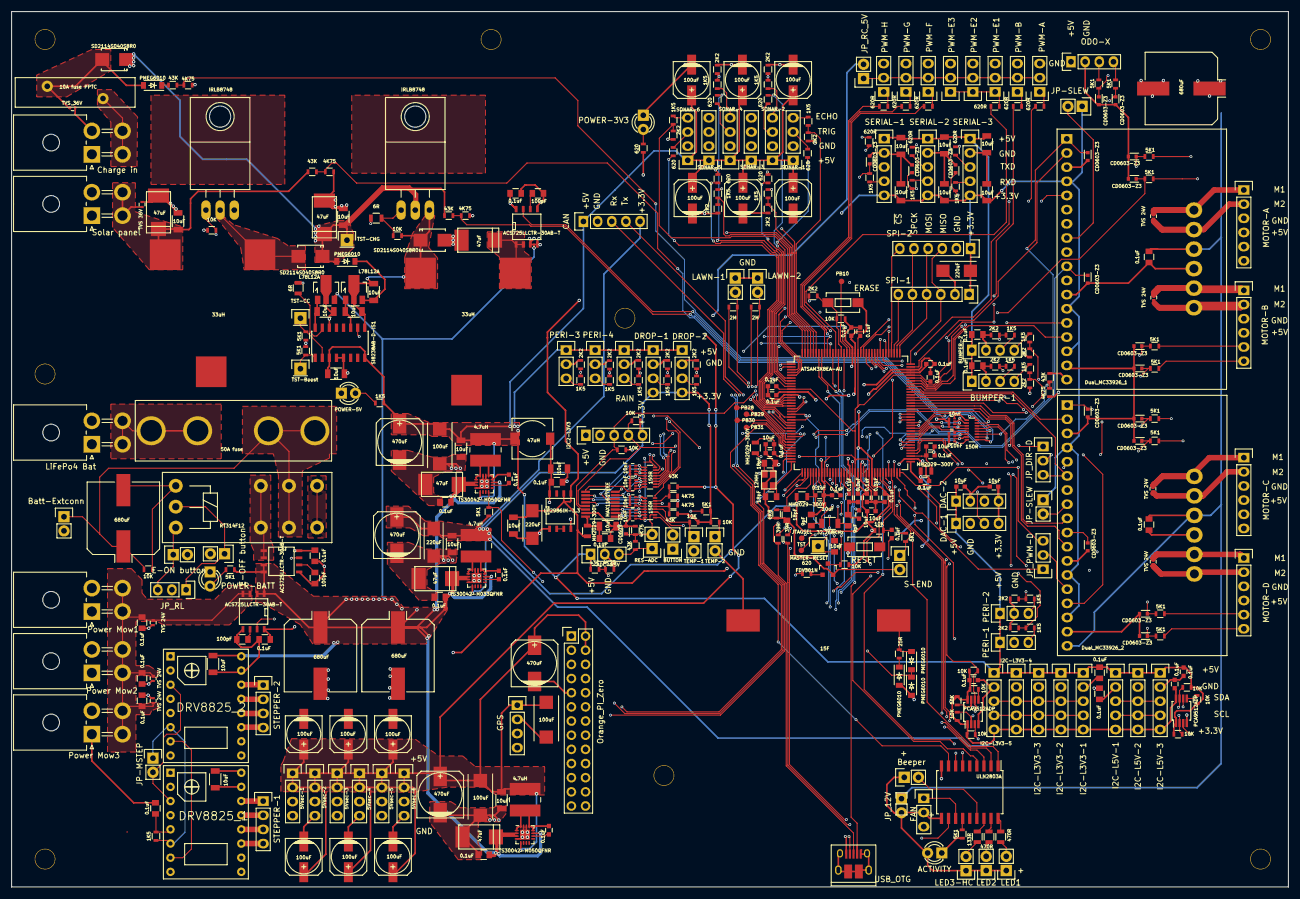
[picture p4: board omower.kicad_pcb from above]

Board: 4 copper layers, 229.0 x 157.0 mm, 413 parts (0 on the bottom side), 298 nets.
