vasimv/OMower/omower-imu.cpp

// IMU class for OMower, GY-80 and MPU9250 (MPU6500+AK8963)
// $Id$

// Problems with Os optimization!
#pragma GCC optimize ("O3")

#include <Arduino.h>
#include <omower-imu.h>
#include <due-i2c-blocking.h>
#include <max11617-adc-scan.h>
#include <omower-motors.h>
#include <omower-debug.h>
#include <omower-ros.h>

#define MADGWICK_RATE 50
#define KALMAN_Q_ANGLE 0.1f
#define KALMAN_Q_BIAS 0.03f
#define KALMAN_R_MEASURE 0.11f

#ifdef IMU_GY80
#define MADGWICK_BETA 0.03f
// -------------I2C addresses ------------------------
#define ADXL345B (0x53)          // ADXL345B acceleration sensor (GY-80 PCB)
#define HMC5883L (0x1E)          // HMC5883L compass sensor (GY-80 PCB)
#define L3G4200D (0xD2 >> 1)     // L3G4200D gyro sensor (GY-80 PCB)
#define BMP085 (0x77)
// LSP per DPS for 2000DPS range
#define L3G4200D_GRES 0.07f
#define DEFAULT_ACCEL_SCALE 250.0f
#endif

#ifdef IMU_MPU9250
#define MADGWICK_BETA 0.25f
#define MPU_ADDR 0x68
#define AK_ADDR 0x0C
#define MPU9250_ID 0x71
#define MPU9255_ID 0x73
#define AK8963_ID 0x48

#define MPU_ARES 16384.0f
#define DEFAULT_ACCEL_SCALE (MPU_ARES)
// // LSB per DPS for 250DPS
// #define MPU_GRES 0.007633588f
// LSB per DPS for 2000DPS range
#define MPU_GRES 0.0609756f

// MPU9250 (MPU6500+AK8963) registers addresses
#define MPU_ACCEL_CONFIG 0x1C
#define MPU_ACCEL_CONFIG2 0x1D
#define MPU_ACCEL_XOUT_H 0x3B
#define MPU_CONFIG 0x1A
#define MPU_FIFO_COUNTH 0x72
#define MPU_FIFO_EN 0x23
#define MPU_FIFO_R_W 0x74
#define MPU_GYRO_CONFIG 0x1B
#define MPU_I2C_MST_CTRL 0x24
#define MPU_INT_ENABLE 0x38
#define MPU_INT_PIN_CFG 0x37
#define MPU_INT_STATUS 0x3A
#define MPU_PWR_MGMT_1 0x6B
#define MPU_PWR_MGMT_2 0x6C
#define MPU_SMPLRT_DIV 0x19
#define MPU_USER_CTRL 0x6A
#define MPU_WHO_AM_I 0x75
#define MPU_XA_OFFSET_H 0x77
#define MPU_XA_OFFSET_L 0x78
#define MPU_XG_OFFSET_H 0x13
#define MPU_XG_OFFSET_L 0x14
#define MPU_YA_OFFSET_H 0x7A
#define MPU_YA_OFFSET_L 0x7B
#define MPU_YG_OFFSET_H 0x15
#define MPU_YG_OFFSET_L 0x16
#define MPU_ZA_OFFSET_H 0x7D
#define MPU_ZA_OFFSET_L 0x7E
#define MPU_ZG_OFFSET_H 0x17
#define MPU_ZG_OFFSET_L 0x18
#define MPU_EXT_SENS_DATA_00 0x49
#define MPU_I2C_SLV0_D0 0x63
#define MPU_I2C_SLV0_ADDR 0x25
#define MPU_I2C_SLV0_REG 0x26
#define MPU_I2C_SLV0_CTRL 0x27
#define AK_WHO_AM_I 0x00
#define AK_AK8963_ASAX 0x10
#define AK_AK8963_CNTL1 0x0A
#define AK_AK8963_CNTL2 0x0B
#define AK_AK8963_ST1 0x02
#define AK_AK8963_XOUT_L 0x03
// Constants
#define MPU_CLOCK_SEL_PLL 0x01
#define MPU_FIFO_RESET 0x04
#define MPU_I2C_MST_CLK 0x0D
#ifdef IMU_MPU6500_PASSTHROUGH
// FIFO enable
#define MPU_I2C_MST_SET 0x40
#else
// FIFO & Master I2C enable
#define MPU_I2C_MST_SET 0x60
#endif
#endif

#ifdef IMU_FXOS8700
#define MADGWICK_BETA 0.03f
// FXOS8700CQ I2C address (with pins SA0=0, SA1=0)
#define FXOS_ADDR 0x1E

#define FXOS_STATUS 0x00
#define FXOS_F_SETUP 0x09
#define FXOS_WHOAMI 0x0D
#define FXOS_XYZ_DATA_CFG 0x0E
#define FXOS_CTRL_REG1 0x2A
#define FXOS_CTRL_REG2 0x2B
#define FXOS_M_CTRL_REG1 0x5B
#define FXOS_M_CTRL_REG2 0x5C
#define FXOS_M_CTRL_REG3 0x5D
#define FXOS_MAX_X_MSB 0x45
#define FXOS_MIN_X_MSB 0x4B
#define FXOS_M_OUT_X_MSB 0x33
#define FXOS_M_OFF_X_MSB 0x3F
#define FXOS_ID 0xC7
#define FXOS_ARES 16384.0f
#define DEFAULT_ACCEL_SCALE (FXOS_ARES)
#endif

#ifdef IMU_FXAS21002
// FXAS21002C I2C address (with pin SA0=0)
#define FXAS_ADDR 0x20

#define FXAS_STATUS 0x00
#define FXAS_WHOAMI 0x0C
#define FXAS_CTRL_REG0 0x0D
#define FXAS_CTRL_REG1 0x13
#define FXAS_CTRL_REG2 0x14
#define FXAS_CTRL_REG3 0x15
#define FXAS_TEMP 0x12
#define FXAS_F_SETUP 0x09
#define FXAS_ID 0xD7
// // LSB per DPS for 250DPS from datasheet (actually, 255?)
// #define FXAS_GRES 0.0078125f
// LSB per DPS for 2000DPS
#define FXAS_GRES 0.0625f
#endif

// permanent calibration values
// #define DEBUG_IMU_CONSTANT

// Print accelerometer/gyro data on each poll
// #define DEBUG_IMU_FULL

// Poll 50 times per second
void imu::poll50() {
  float loopTime;
  unsigned long now;
  float cosRoll, cosPitch, sinRoll, sinPitch;

  // Don't perform anything if we have a problem or disabled
  if (errorStatus != 0 || imuLocked)
    return;

  // debug(L_DEBUG, "imu::poll50\n");
  // Read data from sensors
  #ifdef IMU_GY80
  readBMP085();
  readL3G4200D();
  readADXL345B();
  readHMC5883L();
  #endif
  #ifdef IMU_MPU9250
  readAK8963();
  // Skip calculation if no new data from IMU
  if (!readMPU6500())
    return;
  #endif
  #ifdef IMU_FXOS8700
  if (!readFXOS8700())
    return;
  #endif
  #ifdef IMU_FXAS21002
  if (!readFXAS21002())
    return;
  #endif

  #ifdef IMU_FLIP
  // Flip around X axis
  com.y = -com.y;
  com.z = -com.z;
  acc.y = -acc.y;
  acc.z = -acc.z;
  gyro.y = -gyro.y;
  gyro.z = -gyro.z;
  #endif

  #ifdef IMU_ROTATE_180
  // Rotate IMU to 180 degrees
  com.y = -com.y;
  com.x = -com.x;
  acc.y = -acc.y;
  acc.x = -acc.x;
  gyro.y = -gyro.y;
  gyro.x = -gyro.x;
  #endif

  // Calculate time from previous reading
  now = millis();
  loopTime = (float) (now - lastTime) / 1000.0f;
  lastTime = now;

  // debug(L_DEBUG, (char *) F("IR: %.3f %.3f %.3f %.3f %.3f %.3f %.3f %.3f %.3f %.3f %hu\n"), acc.x, acc.y, acc.z,
  //       com.x, com.y, com.z, gyro.x, gyro.y, gyro.z, loopTime, comSelfTest);
  #ifdef MADGWICK_FILTER
  // Calculate roll, pitch and yaw
  madgwickUpdate();
  // debug(L_DEBUG, (char *) F("IM: %.3f %.3f %.3f %.3f\n"), q0, q1, q2, q3);
  if (comSelfTest == 0) {
    filtPitch = accPitch;
    filtRoll = accRoll;
    filtYaw = comYaw;
  }
  #else
  // Calculate roll and pitch with complementary filter
  accPitch = atan2(-acc.x, sqrt(sq(acc.y) + sq(acc.z)));
  accRoll = atan2(acc.y, acc.z);
  accPitch = scalePIangles(accPitch, filtPitch);
  accRoll = scalePIangles(accRoll, filtRoll);
  #ifdef KALMAN_FILTER
  filtPitch = kalmanY.getAngle(accPitch, gyro.x, loopTime);
  filtRoll = kalmanX.getAngle(accRoll, gyro.y, loopTime);
  #else
  filtPitch = accPitch;
  filtRoll = accRoll;
  #endif
  filtPitch = scalePI(filtPitch);
  filtRoll = scalePI(filtRoll);
  cosRoll = cos(filtRoll);
  cosPitch = cos(filtPitch);
  sinRoll = sin(filtRoll);
  sinPitch = sin(filtPitch);

  if (comSelfTest == 0) {
    float gyroZ;

    comTilt.x = com.x * cosPitch + com.y * sinRoll * sinPitch + com.z * cosRoll * sinPitch;
    comTilt.y = com.y * cosRoll - com.z * sinRoll;
    comYaw = scalePI(atan2(comTilt.y, comTilt.x));
    comYaw = scalePIangles(comYaw, filtYaw);

    // Calculate gyro rate for yaw axis depending on our current orientation
    gyroZ = gyro.z * cosPitch * cosRoll + gyro.x * sinPitch * cosRoll + gyro.y * sinRoll * cosPitch;
 
    filtYaw = complementary(comYaw, -gyroZ, loopTime, filtYaw);
    filtYaw = scalePI(filtYaw);
  }
  #endif

  debug(L_DEBUG, (char *) F("imu: P %g, R %g, Y %g, T %g\n"),
        filtPitch, filtRoll, filtYaw, filtTemp);
#ifdef DEBUG_IMU_FULL
  debug(L_DEBUG, (char *) F("IF: %g %g %g  %g %g %g\n"),
	acc.x, acc.y, acc.z, gyro.x, gyro.y, gyro.z);
#endif

#ifdef IMU_GY80
  // End self test and calculate temperature compensation
  if (comSelfTest == 1) {
    comSelfTest = 0;
    selfHMC5883L(false);
    calcTempComp();
    compassNeedComp = false;
  }

  // Initiate real self-test after collecting raw compass data
   if (comSelfTest == 2) {
    comSelfTest = 1;
    selfHMC5883L(true);
    comRaw.x = com.x;
    comRaw.y = com.y;
    comRaw.z = com.z;
    comTempSelf = filtTemp;
  }

  // Check if temperature difference is high enough to make
  // self-test and calculate temperature compensation
  if ((comSelfTest == 0) && compassNeedComp && (abs(filtTemp - comTempInit) >= 5))
    comSelfTest = 2;
#endif
  reportToROS();
} // void imu::poll50()

// Calibrate accelerometer
_status imu::calibAccel() {
  _status res = _status::NOERR;

#ifdef IMU_GY80
  imuLocked = true;
  res = calibAccelGY80();
  imuLocked = false;
  return res;
#endif
#ifdef IMU_MPU9250
  boolean checked;

  imuLocked = true;
  checked = checkMPU9250();
  calibMPU6500(false);
  initMPU6500();
  initAK8963();
  imuLocked = false;
  if (!checked)
    res = _status::ERR;
#endif
#ifdef IMU_FXOS8700
  imuLocked = true;
  calibFXOS8700();
  imuLocked = false;
#endif

  debug(L_NOTICE, (char *) F("calibAccel: accOfs %f %f %f, accScale %f %f %f\n"),
        accOfs.x, accOfs.y, accOfs.z, accScale.x, accScale.y, accScale.z);
  return res;
} // _status imu::calibAccel() 

// Calibrate gyroscope
_status imu::calibGyro() {
  _status res = _status::NOERR;

  imuLocked = true;
#ifdef IMU_GY80
  res = calibGyroGY80();
#endif
#ifdef IMU_MPU9250
  // Do nothing, calibMPU6500 will calibrate both accelerometer and gyroscope
#endif
#ifdef IMU_FXAS21002
  calibFXAS21002();
#endif
  imuLocked = false;
  return res;
} // _status imu::calibGyro()

#ifdef IMU_MPU9250
// Check MPU9250 is responding
boolean imu::checkMPU9250() {
  uint8_t tmp = 0;
  uint8_t res;

  // Reset FIFO and I2C modules
  i2cWriteOne(bus,MPU_ADDR, MPU_USER_CTRL, 0x07);
  delay(10);
  i2cRead(bus, MPU_ADDR, MPU_WHO_AM_I, &tmp, 1);
  if ((tmp != MPU9250_ID) && (tmp != MPU9255_ID)) {
    debug(L_WARNING, (char *) F("Bad id from MPU9250/MPU6500 (%hd)\n"), tmp);
    errorStatus = 1;
    addError(2);
    return false;
  }
  // Set clock and i2c master interface on MPU9250
  i2cWriteOne(bus, MPU_ADDR, MPU_PWR_MGMT_1, 0);
  delay(100);
  i2cWriteOne(bus, MPU_ADDR, MPU_CONFIG, 0x01);
  i2cWriteOne(bus, MPU_ADDR, MPU_PWR_MGMT_1, MPU_CLOCK_SEL_PLL);
  i2cWriteOne(bus, MPU_ADDR, MPU_USER_CTRL, MPU_I2C_MST_SET);
#ifdef IMU_MPU6500_PASSTHROUGH
  i2cWriteOne(bus, MPU_ADDR, MPU_INT_PIN_CFG, 0x22);
#else
  i2cWriteOne(bus, MPU_ADDR, MPU_INT_PIN_CFG, 0x20);
  i2cWriteOne(bus, MPU_ADDR, MPU_I2C_MST_CTRL, MPU_I2C_MST_CLK);
#endif
  sendAK8963(AK_AK8963_CNTL1, 0);
  i2cWriteOne(bus, MPU_ADDR, MPU_PWR_MGMT_1, 0x80);
  delay(100);
  sendAK8963(AK_AK8963_CNTL2, 1);
  i2cWriteOne(bus, MPU_ADDR, MPU_PWR_MGMT_1, MPU_CLOCK_SEL_PLL);
  i2cWriteOne(bus, MPU_ADDR, MPU_PWR_MGMT_2, 0);
  i2cWriteOne(bus, MPU_ADDR, MPU_USER_CTRL, MPU_I2C_MST_SET);
#ifdef IMU_MPU6500_PASSTHROUGH
  i2cWriteOne(bus, MPU_ADDR, MPU_INT_PIN_CFG, 0x22);
#else
  i2cWriteOne(bus, MPU_ADDR, MPU_INT_PIN_CFG, 0x20);
  i2cWriteOne(bus, MPU_ADDR, MPU_I2C_MST_CTRL, MPU_I2C_MST_CLK);
#endif
  res = recvAK8963(AK_WHO_AM_I, &tmp, 1);
  if (tmp != AK8963_ID) {
    debug(L_WARNING, (char *) F("Bad id from MPU9250/AK8963 (%hd/%hd)\n"), tmp, res);
    errorStatus = 1;
    addError(1);
    return false;
  }
  return true;
} // boolean imu::checkMPU9250()

// MPU6500 init
void imu::initMPU6500() {
  uint8_t c;
  uint8_t data[6];
  int16_t accel_bias_reg[3];
  int16_t gyro_bias[3];

  // wake up device
  i2cWriteOne(bus, MPU_ADDR, MPU_PWR_MGMT_1, 0x00); // Clear sleep mode bit (6), enable all sensors 
  delay(50); // Wait for all registers to reset 

  // Reset
  i2cWriteOne(bus, MPU_ADDR, MPU_PWR_MGMT_1, 0x80);
  delay(50); // Wait for all registers to reset 

  // get stable time source
  // Auto select clock source to be PLL gyroscope reference if ready else
  i2cWriteOne(bus, MPU_ADDR, MPU_PWR_MGMT_1, MPU_CLOCK_SEL_PLL);
  delay(50); 
  
  // Configure Gyro and Thermometer
  // Disable FSYNC and set thermometer and gyro bandwidth to 41 and 42 Hz, respectively; 
  // minimum delay time for this setting is 5.9 ms, which means sensor fusion update rates cannot
  // be higher than 1 / 0.0059 = 170 Hz
  // DLPF_CFG = bits 2:0 = 011; this limits the sample rate to 1000 Hz for both
  // With the MPU9250, it is possible to get gyro sample rates of 32 kHz (!), 8 kHz, or 1 kHz
  i2cWriteOne(bus, MPU_ADDR, MPU_CONFIG, 0x03);  

  // Set sample rate = gyroscope output rate/(1 + SMPLRT_DIV), 100Hz
  i2cWriteOne(bus, MPU_ADDR, MPU_SMPLRT_DIV, 0x09);
 
  // Set gyroscope scale range (2000DPS)
  // Range selects FS_SEL and GFS_SEL are 0 - 3, so 2-bit values are left-shifted into positions 4:3
  i2cRead(bus, MPU_ADDR, MPU_GYRO_CONFIG, &c, 1);
  // c = c & ~0xE0; // Clear self-test bits [7:5] 
  c = c & ~0x03; // Clear Fchoice bits [1:0] 
  c = c | 0x18; // Set GFS bits [4:3]
  i2cWriteOne(bus, MPU_ADDR, MPU_GYRO_CONFIG, c); // Write new GYRO_CONFIG value to register
  
  // Set accelerometer full-scale range configuration (2G)
  i2cRead(bus, MPU_ADDR, MPU_ACCEL_CONFIG, &c, 1); // get current ACCEL_CONFIG register value
  // c = c & ~0xE0; // Clear self-test bits [7:5] 
  c = c & ~0xF8;  // Clear AFS bits [4:3]
  i2cWriteOne(bus, MPU_ADDR, MPU_ACCEL_CONFIG, c); // Write new ACCEL_CONFIG register value

  // Set accelerometer sample rate configuration
  // It is possible to get a 4 kHz sample rate from the accelerometer by choosing 1 for
  // accel_fchoice_b bit [3]; in this case the bandwidth is 1.13 kHz
  i2cRead(bus, MPU_ADDR, MPU_ACCEL_CONFIG2, &c, 1); // get current ACCEL_CONFIG2 register value
  c = c & ~0x0F; // Clear accel_fchoice_b (bit 3) and A_DLPFG (bits [2:0])  
  c = c | 0x03;  // Set accelerometer rate to 1 kHz and bandwidth to 41 Hz
  i2cWriteOne(bus, MPU_ADDR, MPU_ACCEL_CONFIG2, c); // Write new ACCEL_CONFIG2 register value

  // Enable all sensors
  i2cWriteOne(bus, MPU_ADDR, MPU_PWR_MGMT_2, 0x00);

  // Configure Interrupts enable
  // Not really needed on OMower (as it doesn't have connection for INT pin)
#ifdef IMU_MPU6500_PASSTHROUGH
  i2cWriteOne(bus, MPU_ADDR, MPU_INT_PIN_CFG, 0x22);
#else
  i2cWriteOne(bus, MPU_ADDR, MPU_INT_PIN_CFG, 0x20);
#endif
  i2cWriteOne(bus, MPU_ADDR, MPU_INT_ENABLE, 0x01); // Enable data ready (bit 0) interrupt

  // Configure I2C master interface to work with AK8963 (400KHz)
  i2cWriteOne(bus, MPU_ADDR, MPU_PWR_MGMT_1, MPU_CLOCK_SEL_PLL);
  i2cWriteOne(bus, MPU_ADDR, MPU_USER_CTRL, MPU_I2C_MST_SET | 0x07);
#ifndef IMU_MPU6500_PASSTHROUGH
  i2cWriteOne(bus, MPU_ADDR, MPU_I2C_MST_CTRL, MPU_I2C_MST_CLK);
#endif
  i2cWriteOne(bus, MPU_ADDR, MPU_FIFO_EN, 0xF8);     // Enable gyro and accelerometer sensors for FIFO
  delay(50);

  gyro_bias[0] = gyroOfs.x;
  gyro_bias[1] = gyroOfs.y;
  gyro_bias[2] = gyroOfs.z;

  data[0] = (-gyro_bias[0] / 4  >> 8) & 0xFF;
  data[1] = (-gyro_bias[0] / 4)       & 0xFF;
  data[2] = (-gyro_bias[1] / 4  >> 8) & 0xFF;
  data[3] = (-gyro_bias[1] / 4)       & 0xFF;
  data[4] = (-gyro_bias[2] / 4  >> 8) & 0xFF;
  data[5] = (-gyro_bias[2] / 4)       & 0xFF;

  // Push gyro biases to hardware registers
  i2cWriteOne(bus, MPU_ADDR, MPU_XG_OFFSET_H, data[0]);
  i2cWriteOne(bus, MPU_ADDR, MPU_XG_OFFSET_L, data[1]);
  i2cWriteOne(bus, MPU_ADDR, MPU_YG_OFFSET_H, data[2]);
  i2cWriteOne(bus, MPU_ADDR, MPU_YG_OFFSET_L, data[3]);
  i2cWriteOne(bus, MPU_ADDR, MPU_ZG_OFFSET_H, data[4]);
  i2cWriteOne(bus, MPU_ADDR, MPU_ZG_OFFSET_L, data[5]);
} // void imu::initMPU6500()

// Write to AK8963 register through MPU6500
void imu::sendAK8963(uint8_t reg, uint8_t val) {
#ifdef IMU_MPU6500_PASSTHROUGH
  i2cWriteOne(bus, AK_ADDR, reg, val);
#else
  // i2cWriteOne(bus, MPU_ADDR, MPU_I2C_SLV0_CTRL, 0);
  i2cWriteOne(bus, MPU_ADDR, MPU_I2C_SLV0_D0, val);
  i2cWriteOne(bus, MPU_ADDR, MPU_I2C_SLV0_ADDR, AK_ADDR);
  i2cWriteOne(bus, MPU_ADDR, MPU_I2C_SLV0_REG, reg);
  i2cWriteOne(bus, MPU_ADDR, MPU_I2C_SLV0_CTRL, 0x81);
  delayMicroseconds(100);
//  i2cWriteOne(bus, MPU_ADDR, MPU_I2C_SLV0_CTRL, 0x0);
#endif
} // void imu::sendAK8963(uint8_t reg, uint8_t val)

// Read from AK8963 registers through MPU6500
uint8_t imu::recvAK8963(uint8_t reg, uint8_t *buf, uint8_t size) {
  uint8_t tmp;

#ifdef IMU_MPU6500_PASSTHROUGH
  tmp = i2cRead(bus, AK_ADDR, reg, buf, size);
#else
  // i2cWriteOne(bus, MPU_ADDR, MPU_I2C_SLV0_CTRL, 0);
  i2cWriteOne(bus, MPU_ADDR, MPU_I2C_SLV0_ADDR, AK_ADDR | 0x80);
  i2cWriteOne(bus, MPU_ADDR, MPU_I2C_SLV0_REG, reg);
  i2cWriteOne(bus, MPU_ADDR, MPU_I2C_SLV0_CTRL, 0x80 | size);
  // Wait until all data read
  delayMicroseconds(100 + size * 25);
  tmp = i2cRead(bus, MPU_ADDR, MPU_EXT_SENS_DATA_00, buf, size); 
//  i2cWriteOne(bus, MPU_ADDR, MPU_I2C_SLV0_CTRL, 0x0);
#endif
  return tmp;
} // uint8_t imu::recvAK8963(uint8_t reg, uint8_t *buf, uint8_t size)

// AK8963 Magnetometer init
void imu::initAK8963() {
  // First extract the factory calibration for each magnetometer axis
  uint8_t rawData[3];  // x/y/z gyro calibration data stored here
  int res;

  // Reset AK8963
  sendAK8963(AK_AK8963_CNTL1, 0x00); // Power down magnetometer  
  delay(50);
  sendAK8963(AK_AK8963_CNTL2, 0x01);
  delay(50);
  sendAK8963(AK_AK8963_CNTL1, 0x00); // Power down magnetometer  
  delay(10);
  sendAK8963(AK_AK8963_CNTL1, 0x0F); // Enter Fuse ROM access mode
  delay(50);
  res = recvAK8963(AK_AK8963_ASAX, rawData, 3);  // Read the x-, y-, and z-axis calibration values
  if (res == 3) {
    comInit.x = (float)(rawData[0] - 128)/256.0f + 1.0f;   // Return x-axis sensitivity adjustment values, etc.
    comInit.y = (float)(rawData[1] - 128)/256.0f + 1.0f;  
    comInit.z = (float)(rawData[2] - 128)/256.0f + 1.0f; 
    debug(L_NOTICE, (char *) F("imu::initAK8963: FUSE ROM: %g %g %g\n"),
          comInit.x, comInit.y, comInit.z);
  } else
    debug(L_NOTICE, (char *) F("Couldn't read AK8963 FUSE ROM! (%d bytes)\n"), res);

  sendAK8963(AK_AK8963_CNTL1, 0x00); // Power down magnetometer  
  delay(20);

  // Configure the magnetometer for continuous read
  // set Mscale bit 4 to 1 (0) to enable 16 (14) bit resolution in CNTL register,
  // and enable continuous mode data acquisition Mmode (bits [3:0]), 0010 for 8 Hz and 0110 for 100 Hz sample rates
  // 16 bit, 100 Hz
  sendAK8963(AK_AK8963_CNTL1, 0x16); // Set magnetometer data resolution and sample ODR

  delay(20);
} // void imu::initAK8963()

// Read from gyro&accel of MPU6500
boolean imu::readMPU6500() {
  volatile uint16_t tmp = 0;
  int16_t data[7];
  uint8_t i, count;

  acc.x = acc.y = acc.z = gyro.x = gyro.y = gyro.z = filtTemp = 0.0f;

  // Read FIFO counter and calculate number of samples
  if (i2cRead(bus, MPU_ADDR, MPU_FIFO_COUNTH, (uint8_t *) &tmp, 2) != 2) {
    debug(L_NOTICE, (char *) F("Couldn't read from MPU6500!\n"));
    errorStatus = 2;
    addError(2);
    return false;
  }
  swapBytes((uint8_t *) &tmp);
  // Fifo is overfull, just reset
  if (tmp > 128) {
    i2cWriteOne(bus, MPU_ADDR, MPU_USER_CTRL, MPU_I2C_MST_SET | MPU_FIFO_RESET);
    debug(L_NOTICE, (char *) F("MPU6500 FIFO overrun! Resetting fifo\n"));
    return false;
  }
  if ((tmp % 14) != 0) {
    // Uhm, strange number of bytes in FIFO, skip this cycle
    debug(L_NOTICE, (char *) F("Weird number of bytes (%d) in FIFO of MPU6500\n"), tmp);
    i2cWriteOne(bus, MPU_ADDR, MPU_USER_CTRL, MPU_I2C_MST_SET | MPU_FIFO_RESET);
    return false;
  }
  count = tmp / 14;

  if (count == 0) {
    debug(L_DEBUG, (char *) F("No ready data in FIFO of MPU6500!\n"));
    return false;
  }

  // Read all samples FIFO 
  for (i = 0; i < count; i++) { 
    // Read accel, temp and gyro data
    tmp = i2cRead(bus, MPU_ADDR, MPU_FIFO_R_W, (uint8_t *) data, 14);
    if (tmp != 14) { 
      debug(L_NOTICE, (char *) F("Couldn't read MPU6500 data (%hd)\n"), tmp);
      errorStatus = 2;
      addError(2);
      return false;
    }

    // Swap bytes in data array
    for (int i = 0; i < (sizeof(data) / 2); i++)
      swapBytes((uint8_t *) &data[i]);

    // Calculate acceleration (in G), gyro (radiants/s), temperature (celsius)
    acc.x += (-(float) data[0] / accScale.x);
    acc.y += (-(float) data[1] / accScale.y);
    acc.z += ((float) data[2] / accScale.z);
    gyro.x += (-(float) data[4] * ((MPU_GRES * M_PI) / 180.0f));
    gyro.y += (-(float) data[5] * ((MPU_GRES * M_PI) / 180.0f));
    gyro.z += ((float) data[6] * ((MPU_GRES * M_PI) / 180.0f));
    filtTemp += ((float) data[3] / 333.87f + 21.0f);
  }
  acc.x /= (float) count;
  acc.y /= (float) count;
  acc.z /= (float) count;
  acc.x += accOfs.x;
  acc.y += accOfs.y;
  acc.z -= accOfs.z;
  gyro.x /= (float) count;
  gyro.y /= (float) count;
  gyro.z /= (float) count;
  debug(L_DEBUG, (char *) F("acc: %.2f %.2f %.2f gyro: %.2f %.2f %.2f\n"),
        acc.x, acc.y, acc.z, gyro.x, gyro.y, gyro.z);
  filtTemp /= (float) count;
  return true;
} // boolean imu::readMPU6500()

// Read from magnetometer of AK8963
void imu::readAK8963() {
  uint8_t res;
  uint8_t data[8];
  float x, y, z;

  res = recvAK8963(AK_AK8963_ST1, data, 8);
  if (res != 8) {
    debug(L_NOTICE, (char *) F("No data read from AK8963 (%hd)!\n"), res);
    return;
  }
  if ((data[0] & 0x01) && (data[7] & 0x10) && !(data[7] & 0x08)) {
      y= -(int16_t) (((int16_t) data[2] << 8) | data[1]);
      x= -(int16_t) (((int16_t) data[4] << 8) | data[3]);
      z= -(int16_t) (((int16_t) data[6] << 8) | data[5]);
  } else {
    debug(L_NOTICE, (char *) F("No valid data read from AK8963! (0:%02x 7:%02x)\n"), data[0], data[7]);
    return;
  }

  if (x < comMin.x)
    comMin.x = x;
  if (x > comMax.x)
    comMax.x = x;
  if (y < comMin.y)
    comMin.y = y;
  if (y > comMax.y)
    comMax.y = y;
  if (z < comMin.z)
    comMin.z = z;
  if (z > comMax.z)
    comMax.z = z;
  if (compassCalibrated) {
    x = x - comOfs.x;
    y = y - comOfs.y;
    z = z - comOfs.z;
    x /= comScale.x * 0.5f;
    y /= comScale.y * 0.5f;
    z /= comScale.z * 0.5f;
    com.x = x;
    com.y = y;
    com.z = z;
  } else {
    com.x = x;
    com.y = y;
    com.z = z;
  }
} // void imu::readAK8963()

// Calibrate gyro&accel of MPU6500
void imu::calibMPU6500(boolean onlyGyro) {
  uint8_t data[12]; // data array to hold accelerometer and gyro x, y, z, data
  uint16_t i, ii, packet_count, fifo_count, total_count, read_count;
  int32_t gyro_bias[3], accel_bias[3];
  int16_t accel_temp[3], gyro_temp[3];
  int res;

  do {
    // reset device
    i2cWriteOne(bus, MPU_ADDR, MPU_PWR_MGMT_1, 0x80); // Write a one to bit 7 reset bit; toggle reset device
    delay(100);
   
    // get stable time source; Auto select clock source to be PLL gyroscope reference if ready 
    // else use the internal oscillator, bits 2:0 = 001
    i2cWriteOne(bus, MPU_ADDR, MPU_PWR_MGMT_1, 0x01);  
    i2cWriteOne(bus, MPU_ADDR, MPU_PWR_MGMT_2, 0x00);
    delay(200);                                    

    // Configure device for bias calculation
    i2cWriteOne(bus, MPU_ADDR, MPU_INT_ENABLE, 0x00);   // Disable all interrupts
    i2cWriteOne(bus, MPU_ADDR, MPU_FIFO_EN, 0x00);      // Enable FIFO
    i2cWriteOne(bus, MPU_ADDR, MPU_PWR_MGMT_1, 0x00);   // Turn on internal clock source
    i2cWriteOne(bus, MPU_ADDR, MPU_I2C_MST_CTRL, 0x00); // Disable I2C master
    i2cWriteOne(bus, MPU_ADDR, MPU_USER_CTRL, 0x0);    // Disable FIFO and I2C master modes, reset
    // Reset gyro biase hardware registers
    i2cWriteOne(bus, MPU_ADDR, MPU_XG_OFFSET_H, 0);
    i2cWriteOne(bus, MPU_ADDR, MPU_XG_OFFSET_L, 0);
    i2cWriteOne(bus, MPU_ADDR, MPU_YG_OFFSET_H, 0);
    i2cWriteOne(bus, MPU_ADDR, MPU_YG_OFFSET_L, 0);
    i2cWriteOne(bus, MPU_ADDR, MPU_ZG_OFFSET_H, 0);
    i2cWriteOne(bus, MPU_ADDR, MPU_ZG_OFFSET_L, 0);
    i2cWriteOne(bus, MPU_ADDR, MPU_USER_CTRL, 0x07);    // Reset FIFO, I2C, signal paths
    delay(15);
  
    // Configure MPU6050 gyro and accelerometer for bias calculation
    i2cWriteOne(bus, MPU_ADDR, MPU_CONFIG, 0x01);      // Set low-pass filter to 188 Hz
    i2cWriteOne(bus, MPU_ADDR, MPU_SMPLRT_DIV, 0x00);  // Set sample rate to 1 kHz
    i2cWriteOne(bus, MPU_ADDR, MPU_GYRO_CONFIG, 0x00);  // Set gyro full-scale to 250 degrees per second
    i2cWriteOne(bus, MPU_ADDR, MPU_ACCEL_CONFIG, 0x00); // Set accelerometer full-scale to 2 g, maximum sensitivity
 
    uint16_t  accelsensitivity = DEFAULT_ACCEL_SCALE;  // = 16384 LSB/g
  
    total_count = 0;
    // Repeat 10 times (400ms)
    for (i = 0; i < 10; i++) {
      do {
        // Configure FIFO to capture accelerometer and gyro data for bias calculation
        i2cWriteOne(bus, MPU_ADDR, MPU_USER_CTRL, 0x6);   // Reset FIFO  
        delay(5);
        i2cWriteOne(bus, MPU_ADDR, MPU_FIFO_EN, 0x78);     // Enable gyro and accelerometer sensors for FIFO
        i2cWriteOne(bus, MPU_ADDR, MPU_USER_CTRL, 0x40);   // Reset FIFO
        delay(40); // accumulate 40 samples in 40 milliseconds = 480 bytes (512 bytes max FIFO size)

        // At end of sample accumulation, turn off FIFO sensor read
        i2cWriteOne(bus, MPU_ADDR, MPU_FIFO_EN, 0x00);        // Disable gyro and accelerometer sensors for FIFO
        delay(5);
        noInterrupts();
        i2cRead(bus, MPU_ADDR, MPU_FIFO_COUNTH, data, 2); // read FIFO sample count
        interrupts();
        fifo_count = ((uint16_t)data[0] << 8) | data[1];
        packet_count = fifo_count/12;// How many sets of full gyro and accelerometer data for averaging
      } while ((fifo_count % 12) != 0);
      read_count = 0;
  
      for (ii = 0; ii < packet_count; ii++) {
        // Read data from FIFO
        noInterrupts();
        res = i2cRead(bus, MPU_ADDR, MPU_FIFO_R_W, data, 12);
        interrupts();
        if (res != 12)
          continue;

        read_count++;

        // Form signed 16-bit integer for each sample in FIFO
        accel_temp[0] = (int16_t) (((int16_t)data[0] << 8) | data[1]  ) ;
        accel_temp[1] = (int16_t) (((int16_t)data[2] << 8) | data[3]  ) ;
        accel_temp[2] = (int16_t) (((int16_t)data[4] << 8) | data[5]  ) ;    
        gyro_temp[0]  = (int16_t) (((int16_t)data[6] << 8) | data[7]  ) ;
        gyro_temp[1]  = (int16_t) (((int16_t)data[8] << 8) | data[9]  ) ;
        gyro_temp[2]  = (int16_t) (((int16_t)data[10] << 8) | data[11]) ;
    

        // Sum individual signed 16-bit biases to get accumulated signed 32-bit biases
        accel_bias[0] += (int32_t) accel_temp[0];
        accel_bias[1] += (int32_t) accel_temp[1];
        accel_bias[2] += (int32_t) accel_temp[2];
        gyro_bias[0]  += (int32_t) gyro_temp[0];
        gyro_bias[1]  += (int32_t) gyro_temp[1];
        gyro_bias[2]  += (int32_t) gyro_temp[2];
      }
      // Ignore first readings
      if (i == 0)
        accel_bias[0] = accel_bias[1] = accel_bias[2] = gyro_bias[0] = gyro_bias[1] = gyro_bias[2] = 0;
      else
        total_count += read_count;
    }
    // At end of sample accumulation, turn off FIFO sensor read
    i2cWriteOne(bus, MPU_ADDR, MPU_FIFO_EN, 0x00);        // Disable gyro and accelerometer sensors for FIFO

    // Normalize sums to get average count biases
    accel_bias[0] /= (int32_t) total_count;
    accel_bias[1] /= (int32_t) total_count;
    accel_bias[2] /= (int32_t) total_count;
    gyro_bias[0]  /= (int32_t) total_count;
    gyro_bias[1]  /= (int32_t) total_count;
    gyro_bias[2]  /= (int32_t) total_count;
    
    // Remove gravity from the z-axis accelerometer bias calculation
    if (accel_bias[2] > 0L)
      accel_bias[2] -= (int32_t) accelsensitivity;
    else
      accel_bias[2] += (int32_t) accelsensitivity;

  // Check for bad calibration values
  } while ((abs(gyro_bias[0]) > 700) || (abs(gyro_bias[1]) > 700) || (abs(gyro_bias[2]) > 700));

  // Saving calibration values to load into offset registers
  gyroOfs.x = gyro_bias[0];
  gyroOfs.y = gyro_bias[1];
  gyroOfs.z = gyro_bias[2];
  if (!onlyGyro) {
    accScale.x = accScale.y = accScale.z = DEFAULT_ACCEL_SCALE;
    accOfs.x = accel_bias[0] / accScale.x;
    accOfs.y = accel_bias[1] / accScale.y;
    accOfs.z = accel_bias[2] / accScale.z;
    accelCalibrated = true;
  }
  debug(L_NOTICE, (char *) F("calibMPU6500: accOfs: %f %f %f, gyroOfs: %f %f %f (%hu reads)\n"),
        accOfs.x, accOfs.y, accOfs.z, gyroOfs.x, gyroOfs.y, gyroOfs.z, total_count);
  gyroCalibrated = true;
  baroCalibrated = true;
} // void imu::calibMPU6500(boolean onlyGyro)
#endif

#ifdef IMU_FXOS8700
// Read data from FXOS8700 accelerometer+magnetometer
boolean imu::readFXOS8700() {
  uint8_t data[7];
  uint8_t res;
  uint8_t samples = 0;
  int16_t tmpX, tmpY, tmpZ;

  // Zero sum values
  acc.x = acc.y = acc.z = 0.0f;
  com.x = com.y = com.z = 0.0f;

  // Read accelerometer FIFO
  while (1) {
    if ((res = i2cRead(bus, FXOS_ADDR, FXOS_STATUS, (uint8_t *) &data, 7)) != 7) {
      debug(L_DEBUG, (char *) F("No data read from accelerometer FXOS8700 (%hd)!\n"), res);
      errorStatus = 2;
      addError(2);
      return false;
    }

    // Check if fifo is fully read
    if ((data[0] & 0x3F) == 0)
      break;

    tmpX = ((int16_t) data[1] << 8) | data[2];
    tmpY = ((int16_t) data[3] << 8) | data[4];
    tmpZ = ((int16_t) data[5] << 8) | data[6];

    acc.x += (float) tmpX / accScale.x - accOfs.x;
    acc.y += (float) tmpY / accScale.y - accOfs.y;
    acc.z += (float) tmpZ / accScale.z - accOfs.z;
    samples++;
  }

  // Read magnitometer data
  if ((res = i2cRead(bus, FXOS_ADDR, FXOS_M_OUT_X_MSB, data, 6)) != 6) {
    debug(L_DEBUG, (char *) F("No data read from magnetometer FXOS8700 (%hd)!\n"), res);
    errorStatus = 2;
    addError(1);
    return false;
  }
  tmpX = ((int16_t) data[0] << 8) | data[1];
  tmpY = ((int16_t) data[2] << 8) | data[3];
  tmpZ = ((int16_t) data[4] << 8) | data[5];
  com.x = ((float) tmpX - comOfs.x) / (comScale.x * 0.5f);
  com.y = ((float) tmpY - comOfs.y) / (comScale.y * 0.5f);
  com.z = ((float) tmpZ - comOfs.z) / (comScale.z * 0.5f);

  acc.x /= (float) samples;
  acc.y /= (float) samples;
  acc.z /= (float) samples;
  return true;
} // boolean imu::readFXOS8700()

// Restart auto calibration of FXOS8700 magnetometer
void imu::restartAutoCalibFXOS8700() {
  imuLocked = true;
  delay(5);
  // Reset min/max registers
  i2cWriteOne(bus, FXOS_ADDR, FXOS_M_CTRL_REG2, 0x24);
  imuLocked = false;
} // void imu::restartAutoCalibFXOS8700()

// read MIN/MAX/OFFSET data from FXOS8700 magnetometer
void imu::readAutoCalibFXOS8700() {
  volatile struct {
    int16_t x;
    int16_t y;
    int16_t z;
  } data;
  uint8_t i;

  imuLocked = true;
  delay(5);
  // Maximum data
  if (i2cRead(bus, FXOS_ADDR, FXOS_MAX_X_MSB, (uint8_t *) &data, sizeof(data)) != sizeof(data)) {
    debug(L_DEBUG, (char *) F("Can't read maximum from FXOS8700\n"));
    return;
  }
  for (i = 0; i < 3; i++)
    swapBytes((uint8_t *) &data + (i * 2));
  comMax.x = data.x;
  comMax.y = data.y;
  comMax.z = data.z;

  // Minimum data
  if (i2cRead(bus, FXOS_ADDR, FXOS_MIN_X_MSB, (uint8_t *) &data, sizeof(data)) != sizeof(data)) {
    debug(L_DEBUG, (char *) F("Can't read minimum from FXOS8700\n"));
    return;
  }
  imuLocked = false;
  for (i = 0; i < 3; i++)
    swapBytes((uint8_t *) &data + (i * 2));
  comMin.x = data.x;
  comMin.y = data.y;
  comMin.z = data.z;

  comOfs.x = (comMax.x + comMin.x) / 2.0f;
  comOfs.y = (comMax.y + comMin.y) / 2.0f;
  comOfs.z = (comMax.z + comMin.z) / 2.0f;
  comScale.x = comMax.x - comMin.x;
  comScale.y = comMax.y - comMin.y;
  comScale.z = comMax.z - comMin.z;
} // void imu::readAutoCalibFXOS8700()

// Calibrate accelerometer
void imu::calibFXOS8700() {
  volatile double sumX, sumY, sumZ;
  int i, count;

  accOfs.x = accOfs.y = accOfs.z = 0.0f;
  accScale.x = accScale.y = accScale.z = DEFAULT_ACCEL_SCALE;
  accelCalibrated = false;

  sumX = sumY = sumZ = 0.0;
  count = 0;
  // Skip first ten reads
  for (i = 0; i < 10; i++) {
    readFXOS8700();
    delay(20);
  }

  // Read accelerometer 50 times to get acceleration values
  for (i = 0; i < 50; i++) {
    if (readFXOS8700()) {
      sumX += acc.x;
      sumY += acc.y;
      sumZ += acc.z;
      count++;
    }
    delay(20);
  }
  accOfs.x = sumX / (double) count;
  accOfs.y = sumY / (double) count;
  // Suppose earth gravity is 1G
  accOfs.z = -(1.0 - sumZ / (double) count);
  accelCalibrated = true;
  debug(L_NOTICE, (char *) F("FXOS8700 calibration: %.3f %.3f %.3f (%d reads, sums %.3f %.3f %.3f)\n"),
        accOfs.x, accOfs.y, accOfs.z, count, sumX, sumY, sumZ);
} // void imu::calibFXOS8700()

// Initialize FXOS8700 accelerometer+magnetometer
boolean imu::initFXOS8700() {
  uint8_t tmp = 0;

  // Check if we can communicate with FXOS8700 chip
  i2cRead(bus, FXOS_ADDR, FXOS_WHOAMI, &tmp, 1);
  if (tmp != FXOS_ID) {
    debug(L_WARNING, (char *) F("Wrong or ID from FXOS8700 (%hu)!\n"), tmp);
    errorStatus = 1;
    addError(2);
    return false;
  }
  // Reset accelerometer
  i2cWriteOne(bus, FXOS_ADDR, FXOS_CTRL_REG2, 0x40);
  delay(1);
  // Reset magnetometer
  i2cWriteOne(bus, FXOS_ADDR, FXOS_M_CTRL_REG2, 0x40);
  delay(1);
  // Start setting up (standby mode)
  i2cWriteOne(bus, FXOS_ADDR, FXOS_CTRL_REG1, 0x00);
  i2cWriteOne(bus, FXOS_ADDR, FXOS_M_CTRL_REG1, 0x00);

  // Magnetometer - oversampling, 200Hz mode, Hybrid mode (half ODR)
  i2cWriteOne(bus, FXOS_ADDR, FXOS_M_CTRL_REG2, 0x24);
  i2cWriteOne(bus, FXOS_ADDR, FXOS_M_CTRL_REG3, 0xF0);
  // Accelerometer - no filter, maximum sensitivity, oversampling, 200Hz, FIFO
  i2cWriteOne(bus, FXOS_ADDR, FXOS_XYZ_DATA_CFG, 0x00);
  i2cWriteOne(bus, FXOS_ADDR, FXOS_CTRL_REG2, 0x12);
  i2cWriteOne(bus, FXOS_ADDR, FXOS_F_SETUP, 0x40);
  i2cWriteOne(bus, FXOS_ADDR, FXOS_CTRL_REG1, 0x11);
  i2cWriteOne(bus, FXOS_ADDR, FXOS_M_CTRL_REG1, 0x9F);
  delay(20);
  return true;
} // boolean initFXOS8700()
#endif

#ifdef IMU_FXAS21002
// Read data from FXAS21002 gyroscope
boolean imu::readFXAS21002() {
  uint8_t data[7];
  int16_t tmpX, tmpY, tmpZ;
  int8_t tmp;
  uint8_t samples = 0;

  // Clear previous measurements to be sure nothing bad happens
  gyro.x = gyro.y = gyro.z = 0.0f;

  while (1) {
    // Read data
    if (i2cRead(bus, FXAS_ADDR, FXAS_STATUS, (uint8_t *) &data, sizeof(data)) != sizeof(data)) {
      debug(L_DEBUG, (char *) F("Can't read from FXAS21002\n"));
      errorStatus = 2;
      addError(3);
     return false;
    }
    if ((data[0] & 0x3F) == 0)
      break;

    tmpX = ((int16_t) data[1] << 8) | (int16_t) data[2];
    tmpY = ((int16_t) data[3] << 8) | (int16_t) data[4];
    tmpZ = ((int16_t) data[5] << 8) | (int16_t) data[6];

    gyro.x += (float) tmpX * ((FXAS_GRES * M_PI) / 180.0f);
    gyro.y += (float) tmpY * ((FXAS_GRES * M_PI) / 180.0f);
    gyro.z += (float) tmpZ * ((FXAS_GRES * M_PI) / 180.0f);
    if (gyroCalibrated) {
      gyro.x += gyroOfs.x;
      gyro.y += gyroOfs.y;
      gyro.z += gyroOfs.z;
    }
    samples++;
  }
  gyro.x /= (float) samples;
  gyro.y /= (float) samples;
  gyro.z /= (float) samples;

  // Read temperature
  i2cRead(bus,FXAS_ADDR, FXAS_TEMP, (uint8_t *) &tmp, 1);
  filtTemp = tmp;
  return true;
} // boolean imu::readFXAS21002()

// Initialize FXAS21002 gyroscope
boolean imu::initFXAS21002() {
  uint8_t tmp;
  
  // Check if we can communicate with FXAS21002 chip
  i2cRead(bus, FXAS_ADDR, FXAS_WHOAMI, &tmp, 1);
  if (tmp != FXAS_ID) {
    debug(L_WARNING, (char *) F("Wrong or can't read ID from FXAS21002 (%hu)!\n"), tmp);
    errorStatus = 1;
    addError(3);
    return false;
  }

  // Reset
  i2cWriteOne(bus, FXAS_ADDR, FXAS_CTRL_REG1, 0x40);
  delay(1);

  // Configure 2000dps without analog gain, 100Hz ODR, circular buffer FIFO
  i2cWriteOne(bus, FXAS_ADDR, FXAS_CTRL_REG0, 0x00);
  i2cWriteOne(bus, FXAS_ADDR, FXAS_F_SETUP, 0x40);
  i2cWriteOne(bus, FXAS_ADDR, FXAS_CTRL_REG1, 0x0E);
  delay(20);
  if (!gyroCalibrated)
    calibFXAS21002();
  return true;
} // boolean imu::initFXAS21002()

// Calibrate gyroscope
void imu::calibFXAS21002() {
  float sumX, sumY, sumZ;
  int i, count;

  gyroOfs.x = gyroOfs.y = gyroOfs.z = 0.0f;
  gyroCalibrated = false;

  sumX = sumY = sumZ = 0.0f;
  count = 0;
  // Skip first ten reads
  for (i = 0; i < 10; i++) {
    readFXAS21002();
    delay(20);
  }
  
  // Read gyroscope 50 time
  for (i = 0; i < 50; i++) {
    if (readFXAS21002()) {
      sumX += gyro.x;
      sumY += gyro.y;
      sumZ += gyro.z;
      count++;
    }
    delay(20);
  }
  gyroOfs.x = -sumX / count;
  gyroOfs.y = -sumY / count;
  gyroOfs.z = -sumZ / count;
  debug(L_DEBUG, (char *) F("FXAS21002 calibration: %.3f %.3f %.3f\n"), gyroOfs.x, gyroOfs.y, gyroOfs.z);

  gyroCalibrated = true;
} // void imu::calibFXAS21002()
#endif

#ifdef IMU_GY80
// ADXL345B acceleration sensor init
void imu::initADXL345B() {
  debug(L_DEBUG, (char *) F("imu::initADXL345B\n"));
  i2cWriteOne(bus, ADXL345B, 0x2D, 0);
  i2cWriteOne(bus, ADXL345B, 0x2D, 16);
  i2cWriteOne(bus, ADXL345B, 0x2D, 8);
  // Full resolution, 16G
  i2cWriteOne(bus, ADXL345B, 0x31, 0x0B);
  // 100Hz data rate
  i2cWriteOne(bus, ADXL345B, 0x2C, 0x0A);
  // FIFO stream
  i2cWriteOne(bus, ADXL345B, 0x38, 0x9F);
} // void imu::initADXL345B()

// Acceleration sensor calibration
_status imu::calibAccelGY80() {
  float sumX, sumY, sumZ;

  accOfs.x = accOfs.y = accOfs.z = 0.0f;
  accScale.x = accScale.y = accScale.z = DEFAULT_ACCEL_SCALE;
  delay(250);
  sumX = sumY = sumZ = 0.0f;
  for (uint16_t i = 0; i < 50; i++) {
    readADXL345B();
    sumX += acc.x;
    sumY += acc.y;
    sumZ += acc.z;
    delay(20);
  }
  accOfs.x = sumX / 50.0f;
  accOfs.y = sumY / 50.0f;
  // Suppose earth gravity is 1G
  accOfs.z = -(accScale.z - sumZ / 50.0f);
  debug(L_DEBUG, (char *) F("imu::calibAccelGY80: offsets %g %g %g, scale %g %g %g\n"),
        accOfs.x, accOfs.y, accOfs.z, accScale.x, accScale.y, accScale.z);
  accelCalibrated = true;
  return _status::NOERR;
} // void imu::calibAccelGY80()
#endif // IMU_GY80

// Swap two bytes
void imu::swapBytes(uint8_t *p) {
  uint8_t tmp;

  tmp = *p;
  *p = *(p + 1);
  *(p + 1) = tmp;
} // void imu::swapBytes(uint8_t *p)

#ifdef IMU_GY80
// read data from BMP085
void imu::readBMP085() {
  volatile uint16_t ut;
  unsigned long up;
  uint16_t res;
  int32_t x1, x2, b5;
  int32_t x3, b3, b6, p;
  uint32_t b4, b7;

  if (readingTemperature) {
    // Read temperature
    res = i2cRead(bus, BMP085, 0xF6, (uint8_t *) &ut, 2);
    if (res != 2) {
      debug(L_NOTICE, (char *) F("imu::readBMP085: res %d\n"), res);
      errorStatus = 2;
      addError(4);
    }
    swapBytes((uint8_t *) &ut);

    // Calculate temperature
    x1 = (((int32_t) ut - (int32_t) bmpCalib.ac6) * (int32_t) bmpCalib.ac5) >> 15;
    x2 = ((int32_t) bmpCalib.mc << 11) / (x1 + bmpCalib.md);
    filtTemp = ((x1 + x2 + 8) >> 4) / 10.0f;

    // Request to measure pressure
    readingTemperature = false;
    i2cWriteOne(bus, BMP085, 0xF4, 0x34 + (2 << 6));
  } else {
    // Read pressure

    // Request temperature conversion
    readingTemperature = true;
    i2cWriteOne(bus, BMP085, 0xF4, 0x2E);
  }
} // void imu::readBMP085()

// BMP085 temperature/pressure sensor init
void imu::initBMP085() {
  uint8_t *p;
  uint16_t res;

  debug(L_DEBUG, (char *) F("imu::initBMP085\n"));

  // Read calibration values to the bmpCalib structure
  p = (uint8_t *) &bmpCalib;
  for (uint8_t addr = 0xAA; addr < 0xC0; addr += 2) {
    res = i2cRead(bus, BMP085, addr, p, 2);
    if (res != 2) {
      debug(L_NOTICE, (char *) F("imu::initBMP085: res %d\n"), res);
      errorStatus = 1;
      addError(4);
    }
    p += 2;
  }

  // Swap all read bytes
  for (p = (uint8_t *) &bmpCalib; p < ((uint8_t *) &bmpCalib + sizeof(bmpCalib)); p += 2)
    swapBytes(p);

  // Request temperature conversion
  readingTemperature = true;
  i2cWriteOne(bus, BMP085, 0xF4, 0x2E);
} // void imu::initBMP085()

// Turn on/off self test on compass
void imu::selfHMC5883L(boolean test) {
  if (test)
    i2cWriteOne(bus, HMC5883L, 0x00, 0x19);
  else
    i2cWriteOne(bus, HMC5883L, 0x00, 0x18);
} // void imu::selfHMC5883L(boolean test)

// Calculate temperature compensation
void imu::calcTempComp() {
  float tempDiff = filtTemp - comTempInit;

  debug(L_NOTICE, (char *) F("imu::calcTempComp: x/y/z %g %g %g (%g %g %g)\n"), com.x, com.y, com.z, comRaw.x, comRaw.y, comRaw.z);
  comTempScale.x = (comInit.x / (com.x - comRaw.x) - 1) / tempDiff;
  comTempScale.y = (comInit.y / (com.y - comRaw.y) - 1) / tempDiff;
  comTempScale.z = (comInit.z / (com.z - comRaw.z) - 1) / tempDiff;
  debug(L_NOTICE, (char *) F("imu::calcTempComp: compensation x/y/z %g %g %g\n"), comTempScale.x, comTempScale.y, comTempScale.z);
} // void imu::calcTempComp()

// HMC5883L compass sensor init
void imu::initHMC5883L() {
  debug(L_DEBUG, (char *) F("imu::initHMC5883L\n"));
  // 8 samples average, 15Hz, no bias
  // i2cWriteOne(bus, HMC5883L, 0x00, 0x70);
  // no average, 75Hz, no bias
  i2cWriteOne(bus, HMC5883L, 0x00, 0x18);
    
  // gain
  // i2cWriteOne(bus, HMC5883L, 0x01, 0xA0);
  // gain
  i2cWriteOne(bus, HMC5883L, 0x01, 0x40);
  // mode
  i2cWriteOne(bus, HMC5883L, 0x02, 0);


  // Save self-test and temperature values at init
  delay(30);
  readHMC5883L();
  comRaw.x = com.x;
  comRaw.y = com.y;
  comRaw.z = com.z;
  comSelfTest = 1;
  selfHMC5883L(true);
  delay(30);
  readHMC5883L();
  readBMP085();
  comInit.x = com.x - comRaw.x;
  comInit.y = com.y - comRaw.y;
  comInit.z = com.z - comRaw.z;
  comTempInit = filtTemp;
  selfHMC5883L(false);
  comSelfTest = 0;
  compassNeedComp = false;

  // We don't know values for temperature scaling yet, so
  // assume zero compensation for current temperature
  comTempScale.x = comTempScale.y = comTempScale.z = 0; 
  delay(30);
  debug(L_DEBUG, (char *) F("imu::initHMC5883L: selft-test x/y/z %g %g %g, T: %g\n"), comInit.x, comInit.y, comInit.z, comTempInit);
} // void imu::initHMC5883L() {

// Read data from accelerometer
void imu::readADXL345B() {
  float x, y, z;
  uint8_t numFifo, buf[6];
  uint16_t res;
  int32_t sX, sY, sZ;
  
  acc.x = acc.y = acc.z = 0.0f;

  // Get numbers of samples in the FIFO
  if (res = i2cRead(bus, ADXL345B, 0x39, (uint8_t *) buf, 1) != 1) {
    debug(L_NOTICE, (char *) F("imu::readADXL345B: res %d\n"), res);
    errorStatus = 2;
    addError(2);
    return;
  }
  numFifo = buf[0];

  sX = sY = sZ = 0.0f;
  // Read whole fifo buffer
  for (uint8_t i = 0; i < numFifo; i++) {
    if ((res = i2cRead(bus, ADXL345B, 0x32, (uint8_t *) buf, 6)) != 6) {
      debug(L_NOTICE, (char *) F("imu::readADXL345B: res %d\n"), res);
      errorStatus = 2;
      addError(2);
      return;
    }
    sX += (int16_t) (((uint16_t) buf[1]) << 8 | buf[0]);
    sY += (int16_t) (((uint16_t) buf[3]) << 8 | buf[2]);
    sZ += (int16_t) (((uint16_t) buf[5]) << 8 | buf[4]);
  }
  // Convert accelerometer reading
  if (accelCalibrated){
    x = sX / numFifo - accOfs.x;
    y = sY / numFifo - accOfs.y;
    z = sZ / numFifo - accOfs.z;
    x /= accScale.x;
    y /= accScale.y;
    z /= accScale.z;
    acc.x = x;
    acc.y = y;
    acc.z = z;
  } else {
    acc.x = sX / (float) numFifo;
    acc.y = sY / (float) numFifo;
    acc.z = sZ / (float) numFifo;
  }
} // void imu::readADXL345B()

// Read data from compass
void imu::readHMC5883L() {
  float x, y, z;
  uint8_t buf[6];
  uint16_t res;

  if ((res = i2cRead(bus, HMC5883L, 0x03, (uint8_t *) buf, 6)) != 6) {
    debug(L_NOTICE, "imu::readHMC5883L: res %d\n", res);
    addError(1);
    errorStatus = 1;
    return;
  }
  x = (int16_t) (((uint16_t) buf[0]) << 8 | buf[1]);
  y = (int16_t) (((uint16_t) buf[4]) << 8 | buf[5]);
  z = (int16_t) (((uint16_t) buf[2]) << 8 | buf[3]);
  if ((comSelfTest == 0) && (filtTemp != comTempInit)) {
    x *= (1.0f - comTempScale.x * (filtTemp - comTempInit));
    y *= (1.0f - comTempScale.y * (filtTemp - comTempInit));
    z *= (1.0f - comTempScale.z * (filtTemp - comTempInit));
  }
  if (comSelfTest == 0) {
    if (x < comMin.x)
      comMin.x = x;
    if (x > comMax.x)
      comMax.x = x;
    if (y < comMin.y)
      comMin.y = y;
    if (y > comMax.y)
      comMax.y = y;
    if (z < comMin.z)
      comMin.z = z;
    if (z > comMax.z)
      comMax.z = z;
  }
  if (compassCalibrated && (comSelfTest == 0)) {
    x -= comOfs.x;
    y -= comOfs.y;
    z -= comOfs.z;
    x /= comScale.x * 0.5f;
    y /= comScale.y * 0.5f;
    z /= comScale.z * 0.5f;
    com.x = x;
    com.y = y;
    com.z = z;
  } else {
    com.x = x;
    com.y = y;
    com.z = z;
  }
} // void imu::readHMC5883L()

// Read data from gyro
void imu::readL3G4200D() {
  uint8_t fifoReg = 0;
  uint8_t count;

  gyro.x = gyro.y = gyro.z = 0;

  // Check number of unread samples in FIFO buffer
  i2cRead(bus, L3G4200D, 0x2F, &fifoReg, sizeof(fifoReg));
  count = (fifoReg & 0x1F);
  if (count == 0)
    return;
  if (count > (sizeof(gyroFifo) / sizeof(gyroFifo[0])))
    count = sizeof(gyroFifo) / sizeof(gyroFifo[0]);

  memset(gyroFifo, 0, sizeof(gyroFifo));
  i2cRead(bus, L3G4200D, 0xA8, (uint8_t *) gyroFifo, sizeof(gyroFifo[0]) * count);

  for (uint8_t i = 0; i < count; i++) {
      gyro.x += (int16_t) (((uint16_t) gyroFifo[i].xh) << 8 | gyroFifo[i].xl);
      gyro.y += (int16_t) (((uint16_t) gyroFifo[i].yh) << 8 | gyroFifo[i].yl);
      gyro.z += (int16_t) (((uint16_t) gyroFifo[i].zh) << 8 | gyroFifo[i].zl);
      if (gyroCalibrated) {
        gyro.x -= gyroOfs.x;
        gyro.y -= gyroOfs.y;
        gyro.z -= gyroOfs.z;
      }
  }
  gyro.x /= (float) count;
  gyro.y /= (float) count;
  gyro.z /= (float) count;
  if (gyroCalibrated) {
    gyro.x *= L3G4200D_GRES * M_PI / 180.0f;  // convert to radiant per second
    gyro.y *= L3G4200D_GRES * M_PI / 180.0f;
    gyro.z *= L3G4200D_GRES * M_PI / 180.0f;
  }
} // void imu::readL3G4200D()

// calculate gyro offsets
_status imu::calibGyroGY80() {
  struct _vec_float_t ofs;

  debug(L_DEBUG, (char *) F("imu::calibGyroGY80\n"));
  gyroCalibrated = false;
  gyroOfs.x = gyroOfs.y = gyroOfs.z = 0;
  while(true) {
    float zmin = 99999f;
    float zmax = -99999f;

    gyroNoise = 0;
    ofs.x = ofs.y = ofs.z = 0;
    for (uint8_t i = 0; i < 50; i++){
      readL3G4200D();
      zmin = min(zmin, gyro.z);
      zmax = max(zmax, gyro.z);
      ofs.x += gyro.x / 50.0f;
      ofs.y += gyro.y / 50.0f;
      ofs.z += gyro.z / 50.0f;
      // calculate noise with last offset
      gyroNoise += sq(gyro.z - gyroOfs.z) / 50.0f;
    }
    debug(L_INFO, (char *) F("imu::calibGyroGY80: min %g, max %g, ofs.z %g, noise %g\n"),
          zmin, zmax, ofs.z, gyroNoise);
    // Found optimum
    if (gyroNoise < 20)
      break;
    // new offset
    gyroOfs = ofs;
  }
  debug(L_INFO, (char *) F("imu::calibGyroGY80: ofs.x %g, ofs.y %g, ofs.z %g\n"), ofs.x, ofs.y, ofs.z);
  gyroCalibrated = true;
} // _status imu::calibGyroGY80()

// L3G4200D gyro sensor init
boolean imu::initL3G4200D() {
  uint8_t buf[6];
  uint8_t retry = 0;

  debug(L_DEBUG, (char *) F("imu::initL3G4200D\n"));
  while (true) {
    i2cRead(bus, L3G4200D, 0x0F, (uint8_t *) buf, 1);
    if (buf[0] != 0xD3) {
      debug(L_ERROR, (char *) F("imu::initL3G4200D: gyro read error\n"));
      retry++;
      if (retry > 2){
        // set soft error state
        addError(3);
        errorStatus = 2;
        return false;
      }
      delay(1000);
    } else break;
  }

  // Normal power mode, all axes enabled, 100 Hz
  i2cWriteOne(bus, L3G4200D, 0x20, 0b00001100);
  // 2000 degree per second
  i2cWriteOne(bus, L3G4200D, 0x23, 0b00100000);
  i2cRead(bus, L3G4200D, 0x23, (uint8_t *) buf, 1);
  if (buf[0] != 0b00100000){
    // Set hard error status
    debug(L_ERROR, (char *) F("imu::initL3G4200D: gyro write error\n"));
    addError(3);
    errorStatus = 1;
  }
  // Activate FIFO, stream mode
  i2cWriteOne(bus, L3G4200D, 0x24, 0x40);
  i2cWriteOne(bus, L3G4200D, 0x2E, 0x40);

  if (!gyroCalibrated) {
    delay(250);
    calibGyro();
  }
  return true;
}
#endif // IMU_GY80

// Returns error status if there were errors or not calibrated
_hwstatus imu::softError() {
  if (!compassCalibrated || !gyroCalibrated || !baroCalibrated || !accelCalibrated)
    return _hwstatus::DISABLED;
  if (errorStatus)
    return _hwstatus::ERROR;
  return _hwstatus::ONLINE;
} // _hwstatus imu::softError()

// Hardware initialization (once)
_hwstatus imu::begin() {
  debug(L_DEBUG, (char *) F("imu::begin\n"));
  compassCalibrated = gyroCalibrated = baroCalibrated = false;
  accOfs.x = accOfs.y = accOfs.z = 0;
  accScale.x = accScale.y = accScale.z = DEFAULT_ACCEL_SCALE;
  // Default accelration values are not same as calibrated, but close enough
  accelCalibrated = true;
  gyroOfs.x = gyroOfs.y = gyroOfs.z = 0;
  oSave = NULL;
  return _hwstatus::ONLINE;
} // _hwstatus imu::begin()

// (re-)Initialization of IMU
_status imu::init(nvmem *saveMem) {
  debug(L_INFO, (char *) F("imu::init\n"));

  errorStatus = 0;
  adc11617Disable = true;
  com.x = com.y = com.z = acc.x = acc.y = gyro.x = gyro.y = gyro.z = 0.0f;
  acc.z = 1.0f;

  // Check if we have set oSave already (re-init)
  if (!oSave) {
    oSave = saveMem;
    if (oSave) {
      nvmemAddr = oSave->curAddr;
      loadCalib();
    }
  } else {
    oSave->curAddr = nvmemAddr;
    loadCalib();
  }

#ifdef MADGWICK_FILTER
  madgwickInit();
#endif

#ifdef KALMAN_FILTER
  kalmanX.setQangle(KALMAN_Q_ANGLE);
  kalmanX.setQbias(KALMAN_Q_BIAS);
  kalmanX.setRmeasure(KALMAN_R_MEASURE);
  kalmanX.setAngle(0);
  kalmanY.setQangle(KALMAN_Q_ANGLE);
  kalmanY.setQbias(KALMAN_Q_BIAS);
  kalmanY.setRmeasure(KALMAN_R_MEASURE);
  kalmanY.setAngle(0);
#endif

  // Re-init i2c bus
  i2cInit(bus, 400000);

  // Don't have barometer calibration yet
  baroCalibrated = true;

  // Clear tables
  memset((uint8_t *) &com, 0, sizeof(com));
  memset((uint8_t *) &gyro, 0, sizeof(gyro));
  memset((uint8_t *) &acc, 0, sizeof(acc));

  #ifdef IMU_GY80
  // Initialize IMU
  imuLocked = true;
  if (!initL3G4200D()) {
    adc11617Disable = false;
    return _status::ERR;
  }
  initBMP085();
  initADXL345B();
  initHMC5883L();
  imuLocked = false;
  #endif
  #ifdef IMU_MPU9250
  imuLocked = true;
  if (!checkMPU9250()) {
    adc11617Disable = false;
    return _status::ERR;
  }
  if (!gyroCalibrated)
    calibMPU6500(true);
  initMPU6500();
  initAK8963();
  imuLocked = false;
  #endif
  #ifdef IMU_FXOS8700
  if (!initFXOS8700()) {
    adc11617Disable = false;
    return _status::ERR;
  }
  #endif
  #ifdef IMU_FXAS21002
  if (!initFXAS21002()) {
    adc11617Disable = false;
    return _status::ERR;
  }
  #endif

#ifdef DEBUG_IMU_CONSTANT
  if (!compassCalibrated) {
    // permanent debug calibration values
#ifdef IMU_GY80
    comOfs.x = -779f;
    comOfs.y = -320f;
    comOfs.z = 1205.5f;
    comScale.x = 669.00f;
    comScale.y = 884.00f;
    comScale.z = 139.00f;
#else
    comOfs.x = 0.0f;
    comOfs.y = 0.0f;
    comOfs.z = 0.0f;
    comScale.x = 1.0f;
    comScale.y = 1.0f;
    comScale.z = 1.0f;
#endif
    compassCalibrated = true;
  }
#endif
  startCompassCalib();

  adc11617Disable = false;
  return _status::NOERR;
} // _status imu::init(nvmem *saveMem)

#ifdef MADGWICK_FILTER
// Initialize filter
void imu::madgwickInit() {
  invSampleFreq = 1.0f / MADGWICK_RATE;
  q0 = q0Prev = 1.0f;
  q1 = q1Prev = 0.0f;
  q2 = q2Prev = 0.0f;
  q3 = q3Prev = 0.0f;
} // void imu::madgwickInit()

float imu::invSqrt(float x) {
  /* close-to-optimal  method with low cost from
   *  http://pizer.wordpress.com/2008/10/12/fast-inverse-square-root */

  uint32_t i = 0x5F1F1412 - (*(uint32_t*)&x >> 1);

  float tmp = *(float*)&i;
  return tmp * (1.69000231f - 0.714158168f * x * tmp * tmp);
} // float imu::invSqrt(float x)

// float imu::invSqrt(float x) {
//  float halfx = 0.5f * x;
//  float y = x;
//
//  long i = *(long*)&y;
//
//  i = 0x5f3759df - (i>>1);
//  y = *(float*)&i;
//  y = y * (1.5f - (halfx * y * y));
//
//  y = y * (1.5f - (halfx * y * y));
//  return y;
//} // float imu::invSqrt(float x) */

void imu::madgwickUpdate() {
  float recipNorm;
  volatile float s0, s1, s2, s3;
  float qDot1, qDot2, qDot3, qDot4;
  float hx, hy;
  float _2q0mx, _2q0my, _2q0mz, _2q1mx, _2bx, _2bz, _4bx, _4bz, _2q0, _2q1;
  float _2q2, _2q3, _2q0q2, _2q2q3, q0q0, q0q1, q0q2, q0q3, q1q1, q1q2;
  float q1q3, q2q2, q2q3, q3q3;

  // Fix for wrong compass values in case of bad calibration
  if (com.x > 1.0f)
    com.x = 1.0f;
  if (com.x < -1.0f)
    com.x = -1.0f;
  if (com.y > 1.0f)
    com.y = 1.0f;
  if (com.y < -1.0f)
    com.y = -1.0f;
  if (com.z > 1.0f)
    com.z = 1.0f;
  if (com.z < -1.0f)
    com.z = -1.0f;

  // Rate of change of quaternion from gyroscope
  qDot1 = 0.5f * (-q1 * gyro.x - q2 * gyro.y - q3 * gyro.z);
  qDot2 = 0.5f * (q0 * gyro.x + q2 * gyro.z - q3 * gyro.y);
  qDot3 = 0.5f * (q0 * gyro.y - q1 * gyro.z + q3 * gyro.x);
  qDot4 = 0.5f * (q0 * gyro.z + q1 * gyro.y - q2 * gyro.x);
  
  // Compute feedback only if accelerometer measurement valid (avoids NaN in accelerometer normalisation)
  if(!((acc.x == 0.0f) && (acc.y == 0.0f) && (acc.z == 0.0f))) {

    // Normalise accelerometer measurement
    recipNorm = invSqrt(acc.x * acc.x + acc.y * acc.y + acc.z * acc.z);
    acc.x *= recipNorm;
    acc.y *= recipNorm;
    acc.z *= recipNorm;

    // Normalise magnetometer measurement
    recipNorm = invSqrt(com.x * com.x + com.y * com.y + com.z * com.z);
    com.x *= recipNorm;
    com.y *= recipNorm;
    com.z *= recipNorm;

    // Auxiliary variables to avoid repeated arithmetic
    _2q0mx = 2.0f * q0 * com.x;
    _2q0my = 2.0f * q0 * com.y;
    _2q0mz = 2.0f * q0 * com.z;
    _2q1mx = 2.0f * q1 * com.x;
    _2q0 = 2.0f * q0;
    _2q1 = 2.0f * q1;
    _2q2 = 2.0f * q2;
    _2q3 = 2.0f * q3;
    _2q0q2 = 2.0f * q0 * q2;
    _2q2q3 = 2.0f * q2 * q3;
    q0q0 = q0 * q0;
    q0q1 = q0 * q1;
    q0q2 = q0 * q2;
    q0q3 = q0 * q3;
    q1q1 = q1 * q1;
    q1q2 = q1 * q2;
    q1q3 = q1 * q3;
    q2q2 = q2 * q2;
    q2q3 = q2 * q3;
    q3q3 = q3 * q3;

    // Reference direction of Earth's magnetic field
    hx = com.x * q0q0 - _2q0my * q3 + _2q0mz * q2 + com.x * q1q1 + _2q1 * com.y * q2 + _2q1 * com.z * q3 - com.x * q2q2 - com.x * q3q3;
    hy = _2q0mx * q3 + com.y * q0q0 - _2q0mz * q1 + _2q1mx * q2 - com.y * q1q1 + com.y * q2q2 + _2q2 * com.z * q3 - com.y * q3q3;
    _2bx = sqrtf(hx * hx + hy * hy);
    _2bz = -_2q0mx * q2 + _2q0my * q1 + com.z * q0q0 + _2q1mx * q3 - com.z * q1q1 + _2q2 * com.y * q3 - com.z * q2q2 + com.z * q3q3;
    _4bx = 2.0f * _2bx;
    _4bz = 2.0f * _2bz;

    // Gradient decent algorithm corrective step
    s0 = -_2q2 * (2.0f * q1q3 - _2q0q2 - acc.x) + _2q1 * (2.0f * q0q1 + _2q2q3 - acc.y) - _2bz * q2 * (_2bx * (0.5f - q2q2 - q3q3) + _2bz * (q1q3 - q0q2) - com.x) + (-_2bx * q3 + _2bz * q1) * (_2bx * (q1q2 - q0q3) + _2bz * (q0q1 + q2q3) - com.y) + _2bx * q2 * (_2bx * (q0q2 + q1q3) + _2bz * (0.5f - q1q1 - q2q2) - com.z);
    s1 = _2q3 * (2.0f * q1q3 - _2q0q2 - acc.x) + _2q0 * (2.0f * q0q1 + _2q2q3 - acc.y) - 4.0f * q1 * (1 - 2.0f * q1q1 - 2.0f * q2q2 - acc.z) + _2bz * q3 * (_2bx * (0.5f - q2q2 - q3q3) + _2bz * (q1q3 - q0q2) - com.x) + (_2bx * q2 + _2bz * q0) * (_2bx * (q1q2 - q0q3) + _2bz * (q0q1 + q2q3) - com.y) + (_2bx * q3 - _4bz * q1) * (_2bx * (q0q2 + q1q3) + _2bz * (0.5f - q1q1 - q2q2) - com.z);
    s2 = -_2q0 * (2.0f * q1q3 - _2q0q2 - acc.x) + _2q3 * (2.0f * q0q1 + _2q2q3 - acc.y) - 4.0f * q2 * (1 - 2.0f * q1q1 - 2.0f * q2q2 - acc.z) + (-_4bx * q2 - _2bz * q0) * (_2bx * (0.5f - q2q2 - q3q3) + _2bz * (q1q3 - q0q2) - com.x) + (_2bx * q1 + _2bz * q3) * (_2bx * (q1q2 - q0q3) + _2bz * (q0q1 + q2q3) - com.y) + (_2bx * q0 - _4bz * q2) * (_2bx * (q0q2 + q1q3) + _2bz * (0.5f - q1q1 - q2q2) - com.z);
    s3 = _2q1 * (2.0f * q1q3 - _2q0q2 - acc.x) + _2q2 * (2.0f * q0q1 + _2q2q3 - acc.y) + (-_4bx * q3 + _2bz * q1) * (_2bx * (0.5f - q2q2 - q3q3) + _2bz * (q1q3 - q0q2) - com.x) + (-_2bx * q0 + _2bz * q2) * (_2bx * (q1q2 - q0q3) + _2bz * (q0q1 + q2q3) - com.y) + _2bx * q1 * (_2bx * (q0q2 + q1q3) + _2bz * (0.5f - q1q1 - q2q2) - com.z);
    recipNorm = invSqrt(s0 * s0 + s1 * s1 + s2 * s2 + s3 * s3); // normalise step magnitude
    s0 *= recipNorm;
    s1 *= recipNorm;
    s2 *= recipNorm;
    s3 *= recipNorm;

    // Apply feedback step
    qDot1 -= MADGWICK_BETA * s0;
    qDot2 -= MADGWICK_BETA * s1;
    qDot3 -= MADGWICK_BETA * s2;
    qDot4 -= MADGWICK_BETA * s3;
  }

  // Integrate rate of change of quaternion to yield quaternion
  q0 += qDot1 * invSampleFreq;
  q1 += qDot2 * invSampleFreq;
  q2 += qDot3 * invSampleFreq;
  q3 += qDot4 * invSampleFreq;

  // Normalise quaternion
  recipNorm = invSqrt(q0 * q0 + q1 * q1 + q2 * q2 + q3 * q3);
  q0 *= recipNorm;
  q1 *= recipNorm;
  q2 *= recipNorm;
  q3 *= recipNorm;

  // Overflow check!
  if (isnan(q0) || isnan(q1) || isnan(q2) || isnan(q3)) {
    q0 = q0Prev;
    q1 = q1Prev;
    q2 = q2Prev;
    q3 = q3Prev;  
  } else {
    q0Prev = q0;
    q1Prev = q1;
    q2Prev = q2;
    q3Prev = q3;
  }

  accRoll = atan2f(q0*q1 + q2*q3, 0.5f - q1*q1 - q2*q2);
  accPitch = asinf(-2.0f * (q1*q3 - q0*q2));
  // We use negative sign for WEST, not EAST
  comYaw = -atan2f(q1*q2 + q0*q3, 0.5f - q2*q2 - q3*q3);
} // void imu::madgwickUpdate()

#else
// Complementary filter
float imu::complementary(float newAngle, float newRate, float loopTime, float angle) {
  float k = 5.0f;
  float x1 = (newAngle - angle) * k * k;
  float y1 = loopTime * x1;
  float x2 = y1 + (newAngle - angle) * 2.0f * k + newRate;

  angle = loopTime * x2 + angle;
  return angle;
} // float imu::complementary(float newAngle, float newRate, float loopTime, float angle)

#endif

// scale to -M_PI .. M_PI range
float imu::scalePI(float v) {
  float d = v;

  while (d < 0)
    d += 2 * M_PI;
  while (d >= 2 * M_PI)
    d -= 2 * M_PI;
  if (d >= M_PI)
    return (-2 * M_PI + d);
  else {
    if (d < -M_PI)
      return (2 * M_PI +d);
    else
      return d;
  }
} // static float imu::scalePI(float v)

// scale setAngle to same sign as currAngle
float imu::scalePIangles(float setAngle, float currAngle) {
  if ((setAngle >= (M_PI / 2)) && (currAngle <= (-M_PI / 2)))
    return (setAngle - 2 * M_PI);
  else {
    if ((setAngle <= (-M_PI / 2)) && (currAngle >= (M_PI / 2)))
      return (setAngle + 2 * M_PI);
    else
      return setAngle;
  }
} // static float imu::scalePIangles(float setAngle, float currAngle)

// Convert degrees to -M_PI..M_PI range
float imu::degreePI(int16_t angleDegree) {
  return ((float) angleDegree * M_PI) / 180.0f;
} // static float imu::degreePI(float angleDegree)

// Convert -M_PI..M_PI range to degrees
int16_t imu::piDegree(float anglePI) {
  return (anglePI * 180.0f) / M_PI;
} // static uint16_t imu::piDegree(float anglePI)

// Set course
void imu::setCourse(int16_t degree, boolean stopWhenReached) {
  courseCur = degreePI(degree);
  stopFinished = stopWhenReached;
  destReached = false;
} // void imu::setCourse(int16_t degree)

// Error for PID controller
float imu::readCourseError() {
  float d;

  d = scalePI(courseCur - readCurDegreeRad(0));

  // Range check
  if (d < -M_PI)
    d = d + 2 * M_PI;
  else
    if (d > M_PI)
      d = d - 2 * M_PI;

  debug(L_NOTICE, (char *) F("imu::readCourseError: filtYaw %g, inclMag %g, courseCur %g, d %g\n"),
        filtYaw, inclMag, courseCur, d);
  // Check if we've reached needed course
  if (stopFinished && (abs(d) < (M_PI / 20.0f))) {
    destReached = true;
    return -1000;
  }

  return d;
} // float imu::readCourseError()

// Current course in radians
float imu::readCurDegreeRad(numThing n) {
  return scalePI(filtYaw + ((inclMag / 180.0f) * M_PI));
} // float imu::readCurDegreeRad(numThing n)

// Current course
int16_t imu::readCurDegree(numThing n) {
  return piDegree(readCurDegreeRad(0));
} // int16_t imu::readCurDegree(numThing n)

// Current pitch degree
int16_t imu::readCurPitchDegree(numThing n) {
  return piDegree(filtPitch);
} // int16_t imu::readCurPitchDegree(numThing n)

// Current roll degree
int16_t imu::readCurRollDegree(numThing n) {
  return piDegree(filtRoll);
} // int16_t imu::readCurRollDegree(numThing n)

// Current temperature
int16_t imu::readCurTemperature(numThing n) {
  return (int16_t) filtTemp;
} // int16_t imu::readCurTemperature(numThing n)

// Current pressure
// Not implemented yet
int16_t imu::readCurPressure(numThing n) {
  return 0;
} // int16_t imu::readCurPressure(numThing n)

int16_t imu::scaleDegree(int16_t angleDegree) {
  // -180 .. 180
  if ((angleDegree > -180.0f) && (angleDegree < 180.0f))
    return angleDegree;
  // 180..360
  if (angleDegree > 180.0f)
    return angleDegree - 360.0f;
  // -180..-360
  return angleDegree + 360.0f;
} // int16_t imu::scaleDegree(int16_t angleDegree)

// Start compass calibration
_status imu::startCompassCalib() {
  comMin.x = comMin.y = comMin.z = 999999.0f;
  comMax.x = comMax.y = comMax.z = -999999.0f;
#ifdef IMU_FXOS8700
  restartAutoCalibFXOS8700();
#endif
  return _status::NOERR;
} // _status imu::startCompassCalib()

_status imu::stopCompassCalib() {
  float xrange, yrange, zrange;

#ifdef IMU_FXOS8700
  readAutoCalibFXOS8700();
#endif

  xrange = comMax.x - comMin.x;
  yrange = comMax.y - comMin.y;
  zrange = comMax.z - comMin.z;

  comOfs.x = xrange / 2.0f + comMin.x;
  comOfs.y = yrange / 2.0f + comMin.y;
  comOfs.z = zrange / 2.0f + comMin.z;
  comScale.x = xrange;
  comScale.y = yrange;
  comScale.z = zrange;
  debug(L_NOTICE, (char *) F("imu::stopCompassCalib: scale %f %f %f offs %f %f %f\n"),
        comScale.x, comScale.y, comScale.z, comOfs.x, comOfs.y, comOfs.z);
  debug(L_NOTICE, (char *) F("imu::stopCompassCalib: min %f %f %f max %f %f %f\n"),
        comMin.x, comMin.y, comMin.z, comMax.x, comMax.y, comMax.z);
  compassCalibrated = true;
  return _status::NOERR;
} // _status imu::stopCompassCalib()

// Save calibration values in NVMEM
_status imu::saveCalib() {
  uint8_t i;

  if (oSave) {
    oSave->curAddr = nvmemAddr;
    debug(L_NOTICE, (char *) F("Saving IMU calibration to %04x\n"), oSave->curAddr);
    if (compassCalibrated) {
      oSave->writeMem(comOfs.x);
      oSave->writeMem(comOfs.y);
      oSave->writeMem(comOfs.z);
      oSave->writeMem(comScale.x);
      oSave->writeMem(comScale.y);
      oSave->writeMem(comScale.z);
    } else
      // No calibration values, write fake
      for (i = 0; i < 6; i++)
        oSave->writeMem(-9999.0f);
    if (!compassNeedComp) {
      oSave->writeMem(comTempScale.x);
      oSave->writeMem(comTempScale.y);
      oSave->writeMem(comTempScale.z);
    } else
      for (i = 0; i < 3; i ++)
        oSave->writeMem(-9999.0f);
    if (accelCalibrated) {
      oSave->writeMem(accOfs.x);
      oSave->writeMem(accOfs.y);
      oSave->writeMem(accOfs.z);
      oSave->writeMem(accScale.x);
      oSave->writeMem(accScale.y);
      oSave->writeMem(accScale.z);
    } else
      // No calibration values, write fake
      for (i = 0; i < 6; i++)
        oSave->writeMem(-9999.0f);
  }
  return _status::NOERR;
} // _status imu::saveCalib()

// Load calibration values from NVMEM
_status imu::loadCalib() {
  float tmpX, tmpY, tmpZ;

  if (oSave) {
    debug(L_NOTICE, (char *) F("Loading IMU calibration from %04x\n"), nvmemAddr);
    oSave->curAddr = nvmemAddr;
    oSave->readMem(tmpX);
    oSave->readMem(tmpY);
    oSave->readMem(tmpZ);
    // Check if we have real calibration data
    if (oSave->haveValid && (tmpX != -9999.0f)) {
      comOfs.x = tmpX;
      comOfs.y = tmpY;
      comOfs.z = tmpZ;
    }
    oSave->readMem(tmpX);
    oSave->readMem(tmpY);
    oSave->readMem(tmpZ);
    // Check if we have real calibration data
    if (oSave->haveValid && (tmpX != -9999.0f)) {
      comScale.x = tmpX;
      comScale.y = tmpY;
      comScale.z = tmpZ;
      compassCalibrated = true;
    }
    oSave->readMem(tmpX);
    oSave->readMem(tmpY);
    oSave->readMem(tmpZ);
    // Check if we have real calibration data
    if (oSave->haveValid && (tmpX != -9999.0f)) {
      comTempScale.x = tmpX;
      comTempScale.y = tmpY;
      comTempScale.z = tmpZ;
      compassNeedComp = false;
    }
    oSave->readMem(tmpX);
    oSave->readMem(tmpY);
    oSave->readMem(tmpZ);
    // Check if we have real calibration data
    if (oSave->haveValid && (tmpX != -9999.0f)) {
      accOfs.x = tmpX;
      accOfs.y = tmpY;
      accOfs.z = tmpZ;
    }
    oSave->readMem(tmpX);
    oSave->readMem(tmpY);
    oSave->readMem(tmpZ);
    // Check if we have real calibration data
    if (oSave->haveValid && (tmpX != -9999.0f)) {
      accScale.x = tmpX;
      accScale.y = tmpY;
      accScale.z = tmpZ;
      accelCalibrated = true;
    }
    debug(L_NOTICE, (char *) F("IMU calibration: accOfs: %f %f %f, accScale: %f %f %f, comOfs: %f %f %f, comScale: %f %f %f\n"),
          accOfs.x, accOfs.y, accOfs.z, accScale.x, accScale.y, accScale.z,
          comOfs.x, comOfs.y, comOfs.z, comScale.x, comScale.y, comScale.z);
  }
  return _status::NOERR;
} // _status imu::loadCalib()

#ifdef USE_ROS
int16_t rosOrient[3];
#endif

// Force report to ROS
void imu::reportToROS() {
#ifdef USE_ROS
  rosOrient[0] = readCurPitchDegree(0);
  rosOrient[1] = readCurRollDegree(1);
  rosOrient[2] = readCurDegree(-1);

  oROS.reportToROS(reportSensor::ORIENTATION, (uint8_t *) rosOrient, 3);
#endif
} // void imu::reportToROS()
