vasimv/OMower/omower-defs.h

// Hardware definitions for OMower
// $Id$

#define USE_ROS

// Test smallcar chassis with IHM12A1
// #include <omower-defs-smallcar.h>

// OMower v3/v4 PCB
// #include <omower-defs-omowerv3.h>

// Test smallcar chassis with stepper motors on wheels and 2x DRV8825
#include <omower-defs-steppercar.h>
