vasimv/OMower/omower-drop.cpp

// Drop sensors support for OMower
// $Id$
                        
#include <omower-drop.h>

// Not implemented yet
uint16_t drop::readSensor(numThing n) {
  return 0;
} // uint16_t drop::readSensor(numThing n)

// Software initialization stuff
// Not implemented yet
_status drop::init() {
  return _status::NOERR;
} // _status drop::init()

// Not implemented yet
void drop::poll10() {
} // void drop::poll10()
