vasimv/OMower/omower-lawn.cpp

// Lawn sensors support for OMower
// $Id$

#include <omower-lawn.h>

// Not implemented yet
boolean lawn::readSensor(numThing n) {
  return false;
} // boolean lawn::readSensor(numThing n)

// Software initialization stuff
// Not implemented yet
_status lawn::init() {
  return _status::NOERR;
} // _status lawn::init()

// Not implemented yet
void lawn::poll10() {
} // void lawn::poll10()
