vasimv/OMower/omower-rain.cpp

// Rain sensor support for OMower
// $Id$

#include <omower-rain.h>

// Not implemented yet
boolean rain::readSensor(numThing n) {
  return false;
} // boolean rain::readSensor(numThing n)

// Software initialization stuff
// Not implemented yet
_status rain::init() {
  return _status::NOERR;
} // _status rain::init()

// Not implemented yet
void rain::poll10() {
} // void rain::poll10()
