vasimv/OMower/(commit log)

2018-01-07 Initial import
    [omower-pin-mapping.csv, omower.kicad_pcb, omower.sch]
2018-04-05 Fixed wrong i2c interface bus update
    [due-i2c-blocking.cpp]
2018-04-05 Added emergency relay shutdown routine
2018-04-08 Added bumper sensors support
2018-04-11 DMA transfer for console (debug + modbus/pfodApp)
2018-04-29 Added FXOS8700C+FXAS21002C support, MPU9250 debug, added Madgwick filter for IMU data fusion
2018-04-30 Removed filter defines
2018-05-02 Fixed problems with GCC optimizations, added "f" suffix to prevent double
    [omower-imu.cpp, omower-imu.h]
2018-05-02 Added NO_CALIB_ACCEL define to stop accelerometer calibration at start
2018-05-15 Added enableThings()/disableThings() to save power
2018-05-27 Added minimum solar panel voltage to keep (Vmp), updated shutdown subroutine
2018-05-27 Added disable option to save power/avoid conflicts on I2C
    [max11617-adc-scan.cpp, max11617-adc-scan.h]
2018-05-27 Fix for no-bumpers scenario
    [omower-bumper.cpp]
2018-05-27 Fix for default height
    [omower-mow.cpp]
2018-05-27 Fix for revision number save
    [omower-nvmem.cpp]
2018-05-27 Fixes for madgwick overflow, added function to return yaw in radians (precise)
    [omower-imu.cpp, omower-imu.h]
2018-05-27 Switching to use radians, current target coordinates are public now
2018-05-27 Added volatile for fix optimization errors
    [omower-currentmow.h]
2018-05-27 Added support for chassis with stepper motors on wheels
2018-05-27 Stop mowing motor when not movingy
2018-05-29 Added compile-time define to disable battery check
2018-05-29 Added additional protection against bad calibration values in madgwick's filter
2018-05-29 Lower speed when big course error
    [omower-motors.cpp]
2018-06-13 Fixed turning with stepper drivers
    [omower-motors.cpp]
2018-06-13 Added errorStatus update at IMU reads
    [omower-imu.cpp]
2018-06-13 Added periodic empty charge cycles to check real battery voltage
2018-06-13 Added compile option to invert EXT_LED1
    [omower-buttonsleds.cpp]
2018-06-18 Fix for speed limiting while on moving when PID-controlled
    [omower-motors.cpp]
2018-06-19 Added pass-through mode to GPS module, fixed initialization stuff
    [omower-radiotag.cpp, omower-radiotag.h]
2018-07-10 Fix for loading IMU settings at restart
    [omower-imu.cpp]
2018-07-11 Added stubs for sensors
2018-10-02 Added support for MPU-9255, switched to old-style accelerometer offset applying (not working well on MPU-9255)
    [omower-imu.cpp]
2018-10-05 Fix for pins initialization
    [omower-bumper.cpp]
2018-10-16 Rework on accelerometer calibration, MPU9250 passthrough mode support
    [omower-imu.cpp, omower-imu.h]
2018-10-29 Added compass auto-correction for precise driving
    [omower-gps.cpp, omower-gps.h]
2018-11-09 Fix for reaching destination checky
    [omower-imu.cpp]
2018-11-09 Fix for right direction when turning around
    [omower-motors.cpp]
2018-11-09 Added IMU-guided mode for more smooth moving
2018-11-27 Fix for slow optical recognition (the module stores 5 values of compass orientation with 100ms between to get better sync with current orientation)
    [omower-seeker.cpp, omower-seeker.h]
2018-12-17 ROS support added, various cleanups and fixes
    [due-i2c-blocking.cpp, omower-bumper.cpp, omower-bumper.h, omower-buttonsleds.cpp, omower-buttonsleds.h, omower-chassis.cpp, omower-current.cpp, omower-currentmotors.cpp]
2019-04-12 Sligthly increased charging current when battery is nearly full
2019-04-12 Added direct RPM set and variables for wheels size
